carlosgj/Lorentz-Stirrer/Report.pdf

# Magnetohydrodynamic Cocktail Stirrer

Carlos Gross Jones

December 16, 2016

Abstract

1


Figure 1: First iteration of contactless stirrer

## 1 Background

The first attempt at a contactless cocktail stirrer was based on a simple application of the Lorentz force. Two copper electrodes placed in a glass tumbler passed a current through the liquid, while a strong magnet (a 2”x1”x³⁄4” N45 block from United Nuclear Scientific LLC) under the tumbler provided an orthogonal magnetic field (Fig. 1). Assuming time-invariance, the force applied on a differential element dV in a current field J~ and an orthogonal magnetic field B~ can be found from the element length d` parallel to the current and cross-sectional area dA normal to the current:
F~ = qV~ × B~ | (1)

F~ = I

~` × B | (2)
I = |J|dA | (3)
(4)

(Valid because dA is defined to be normal to J~.)

dF~ = |J~|dAd` × B~ | (5)

Since, in this case, the magnetic and current fields are orthogonal, and since the current field is approximately uniform between the electrodes (simply the total current divided by the electrode area),

dF~ = |J~||B~ |dA d` | (6)

F~ =

# Z Z Z

V

|J~||B~ |dA d` | (7)

Given an electrode area of A and spacing of L and approximating both the current and magnetic field to be uniform between the electrodes,

F~ = |B~ |L

# Z Z Z

A

|J~|dA = |B~ |IL | (8)

2

This design did work in principle; the Lorentz force produced a pumping action, where fluid would flow down the centerline between the electrodes and recirculate along the walls of the tumbler. However, since a large current was flowing through a fluid, significant electrolysis occurred, which, in addition to producing potentially dangerous hydrogen and oxygen gas, affected the taste of the cocktail due to the electrolysis products.

## 2 Theoretical Background

Since the basic application of Lorentz force to pumping was effectively validated (and is in fact well studied [1]), the major problem remaining was the electrolysis of the cocktail. As per Faraday’s Law of Electrolysis:

m˙ =

I
F

M
z

(9)

Where:

m˙ is the mass of electrolysis products appearing at an electrode per unit time;

I is the total current flowing into or out of the electrode;

F is the Faraday constant, 96485 mol/C;

M is molar mass of the original substance;

z is the number of valence electrons of the substance.

Since F is a constant and M and z are properties of the substance, in order to minimize ˙m, I must be minimized. However, pumping force is also directly proportional to I. The central proposal of this project is that currents which circulate entirely within a fluid will not result in electrolysis, because the net current flow through the fluid is zero.
The obvious question is how to produce currents without an external EMF source such as a battery. The proposed solution is to use an external, time-variant magnetic field to induce circulating currents (eddy currents) in a conductive fluid.
For the purposes of a first-pass analysis, the following model will be considered:

The fluid will be a 3” diameter, 3” tall cylinder (based on an approximate cocktail tumbler);

The fluid will be considered to have electrical resistivity ρ and magnetic properties equal to a vacuum (water is in fact weakly diamagnetic, but this is expected to be a negligible contribution);

Since, at this point, the goal is to find the form of the current field and its dependence on Bs,max and ρ, it is not necessary to accurately know the resistivity of an actual cocktail; those values are calculated separately.
In fact, this application is an adaption of the well-studied eddy current brake (Fig. 2). In this case, however, the magnets are made to spin, resulting in “dragging” of the cylinder. Specifically, if a magnetic field passing through a conductive cylinder radially is made to rotate about the cylinder’s axis, currents will be produced in the cylinder, which interact with the field via Lorentz force. Since the strength of the eddy currents, and by extension the resulting force, is proportional to dB
dt

, both the strength of the applied magnetic field and its rate of change should be maximized.

### 2.1 General Design

The obvious way to produce a strong time-variant magnetic field is with an AC solenoid: they are well characterized and fairly easy to control, and of course relatively easy to build. Unfortunately, to produce the high field strengths needed (on the order of 1 T), the power required for a normal solenoid exceeds the

3


Figure 2: Eddy current disk brake

capabilities of household circuits. Due to the expense and safety issues, a superconducting solenoid was not practical. Therefore, large permanent magnets were considered. 3” dia. x 1” thick NdFeB45 magnets from United Nuclear Scientific LLC were chosen based on field strength per dollar ($140 and maximum B~ · ~n of ≈0.42 T). In order to produce the greatest possible magnetic field, four of these magnets are arranged in a quadrupole configuration. In addition, high-permeability material (in this case, 1020 steel) is used to provide return paths for the field, further increasing the intensity inside the assembly (Fig. 3).
The downside of permanent magnets, of course, is that they must be in motion to produce a time-variant field. In this case, the quadrupole assembly must be spun about the axis of the cocktail, producing circular forces on the liquid (Fig. 4).

## 3 Rotor Design

## 4 Property Measurements

### 4.1 Cocktail Resistivity

### 4.2 Rotor Field Measurement

## References

[1] Takezawa, | Setsuo | et | al. | “Operation | of | the | Thruster | for | Superconducting | Elec-
tromagnetohydrodynamic | Propulsion | Ship | YAMATO | 1.” | Bulletin | of | the | M.E.S.J
23.1 | (1993): | 46-55. | Japan | Institute | of | Marine | Engineering. | Web. | 21 | Aug. | 2016.
<http://www.jime.jp/e/publication/bulletin/english/pdf/mv23n011995p46.pdf¿.>
[2] Matula, | R. A. “Electrical Resistivity of Copper, | Gold, | Palladium, | and Silver.” | Jour-
nal of Physical and Chemical Reference Data 8.4 (1979): | 1161. Web. 23 Aug. 2016.
<http://www.nist.gov/data/PDFfiles/jpcrd155.pdf>.
[3] Bowler, John R., and Theodoros P. Theodoulidis. “Eddy Currents Induced in a Conducting Rod of Finite Length by a Coaxial Encircling Coil.” Journal of Physics D: Applied Physics 38.16 (2005): 2861-868. Web. 23 Aug. 2016.

4

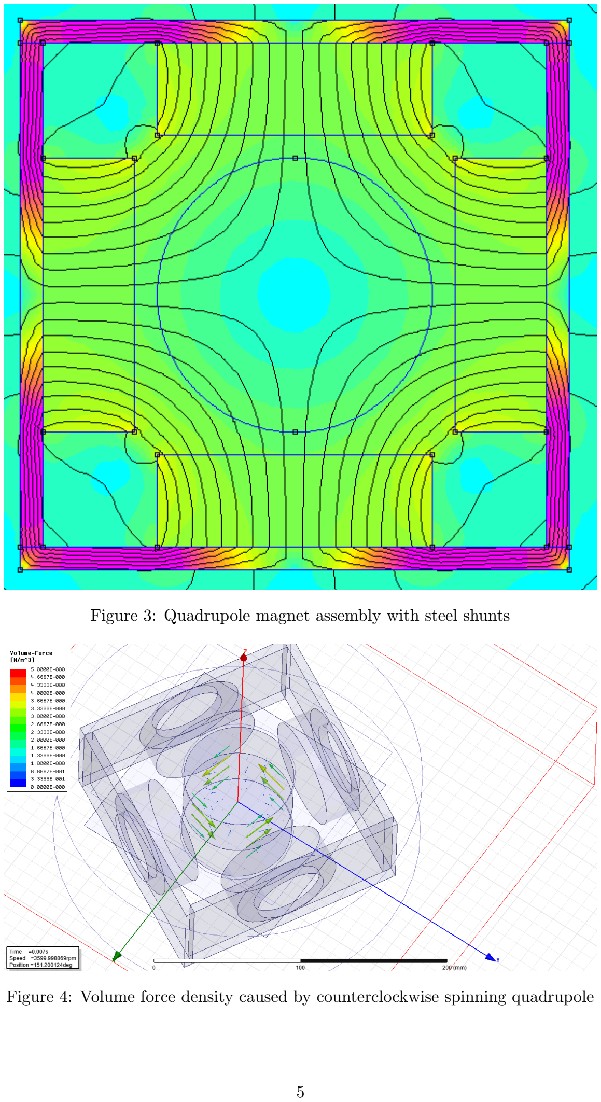
[picture p6: page 5]

Figure 3: Quadrupole magnet assembly with steel shunts

Figure 4: Volume force density caused by counterclockwise spinning quadrupole

5
