carlosgj/Lorentz-Stirrer/CAD/Bare Frame Remder.png

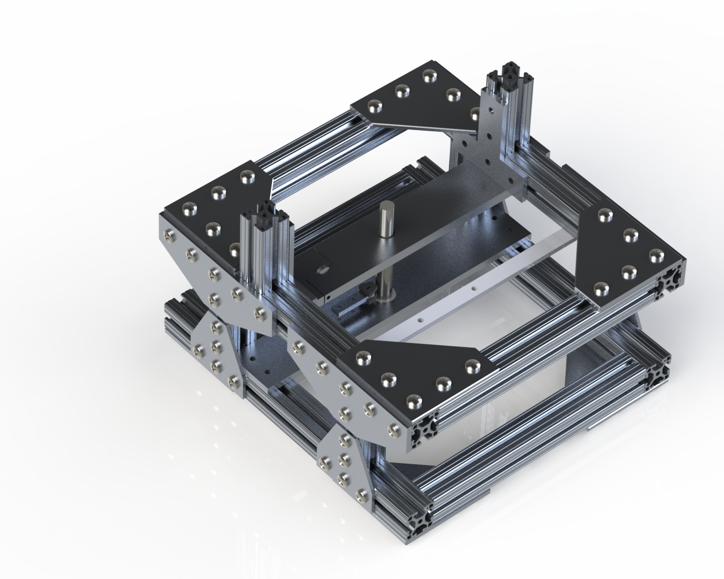
CAD/Bare Frame Remder.png
