carlosgj/Lorentz-Stirrer/CAD/Cutaway.PNG

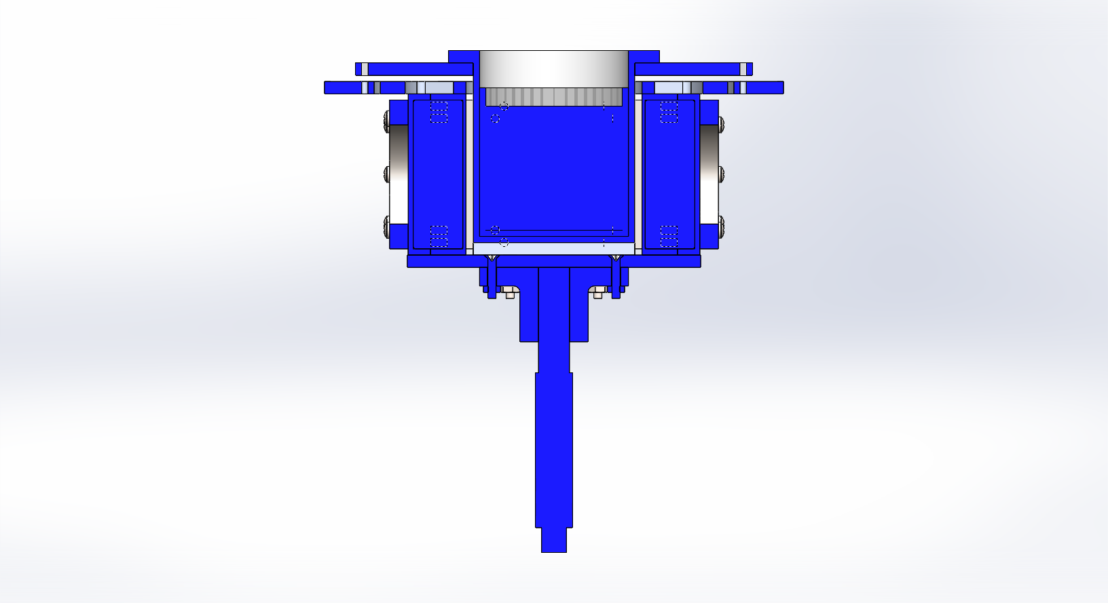
CAD/Cutaway.PNG
