carlosgj/Lorentz-Stirrer/CAD/Pictures/Cutaway.PNG

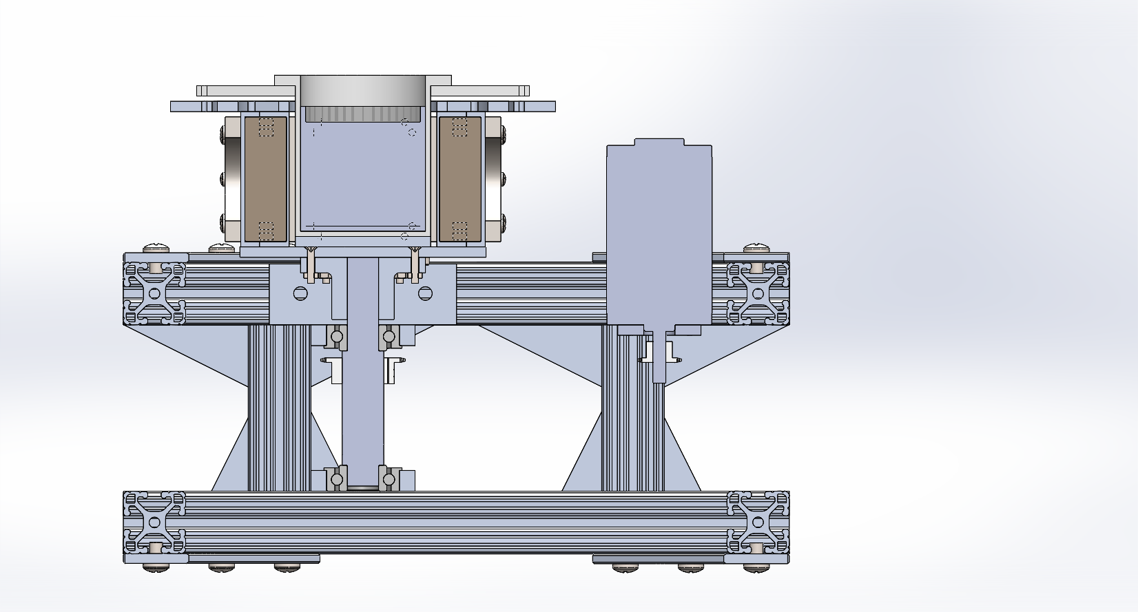
CAD/Pictures/Cutaway.PNG
