carlosgj/Lorentz-Stirrer/CAD/Pictures/Overall Render.png

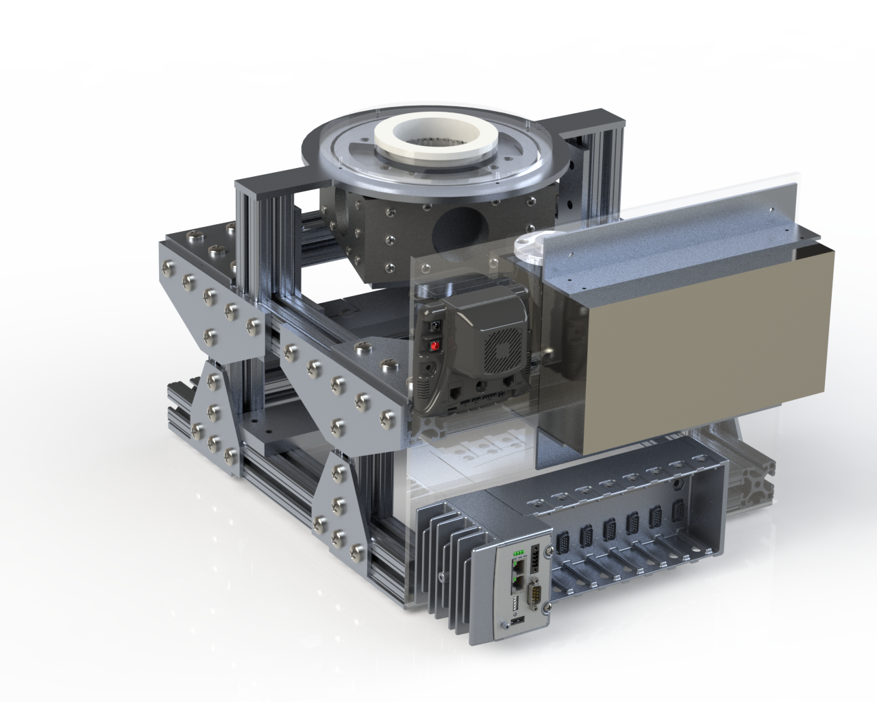
CAD/Pictures/Overall Render.png
