carlosgj/Lorentz-Stirrer/CAD/Spinner and Cup Render.png

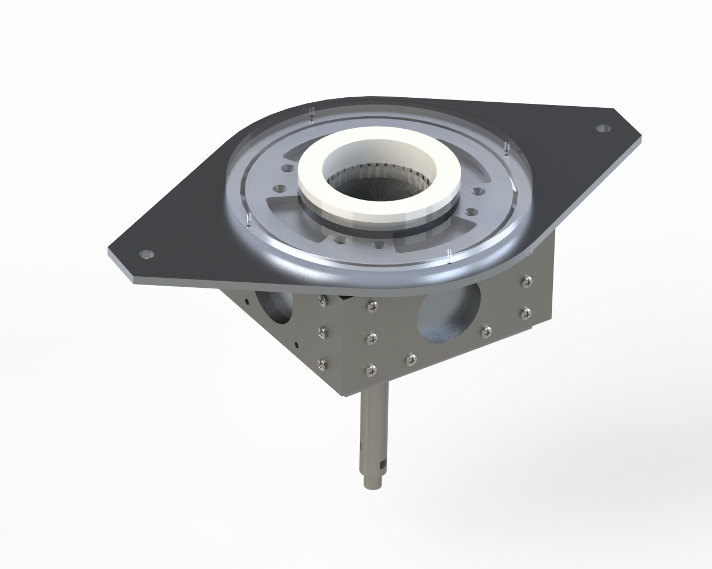
CAD/Spinner and Cup Render.png
