carlosgj/Lorentz-Stirrer/FEMM/Quadrupole.png

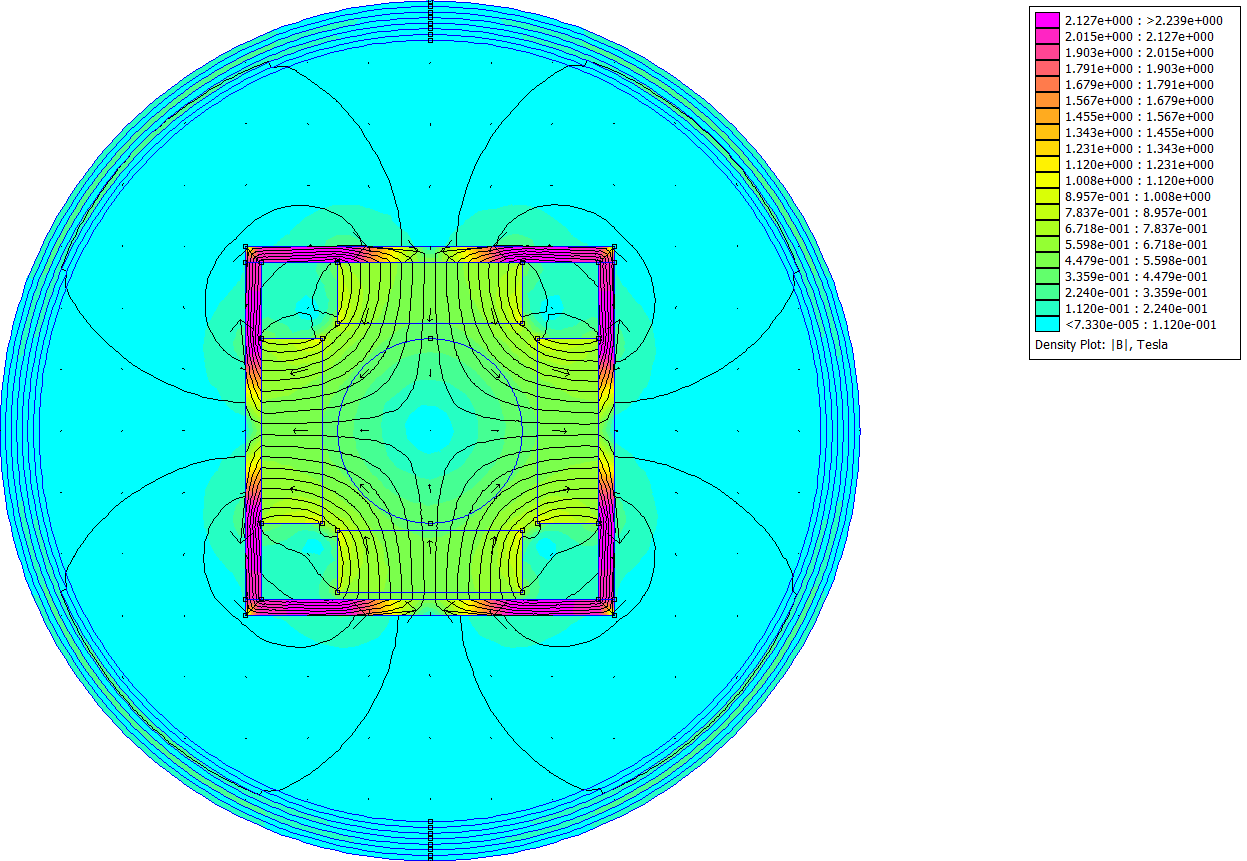
FEMM/Quadrupole.png
