carlosgj/Lorentz-Stirrer/VolumeForceDensity.gif

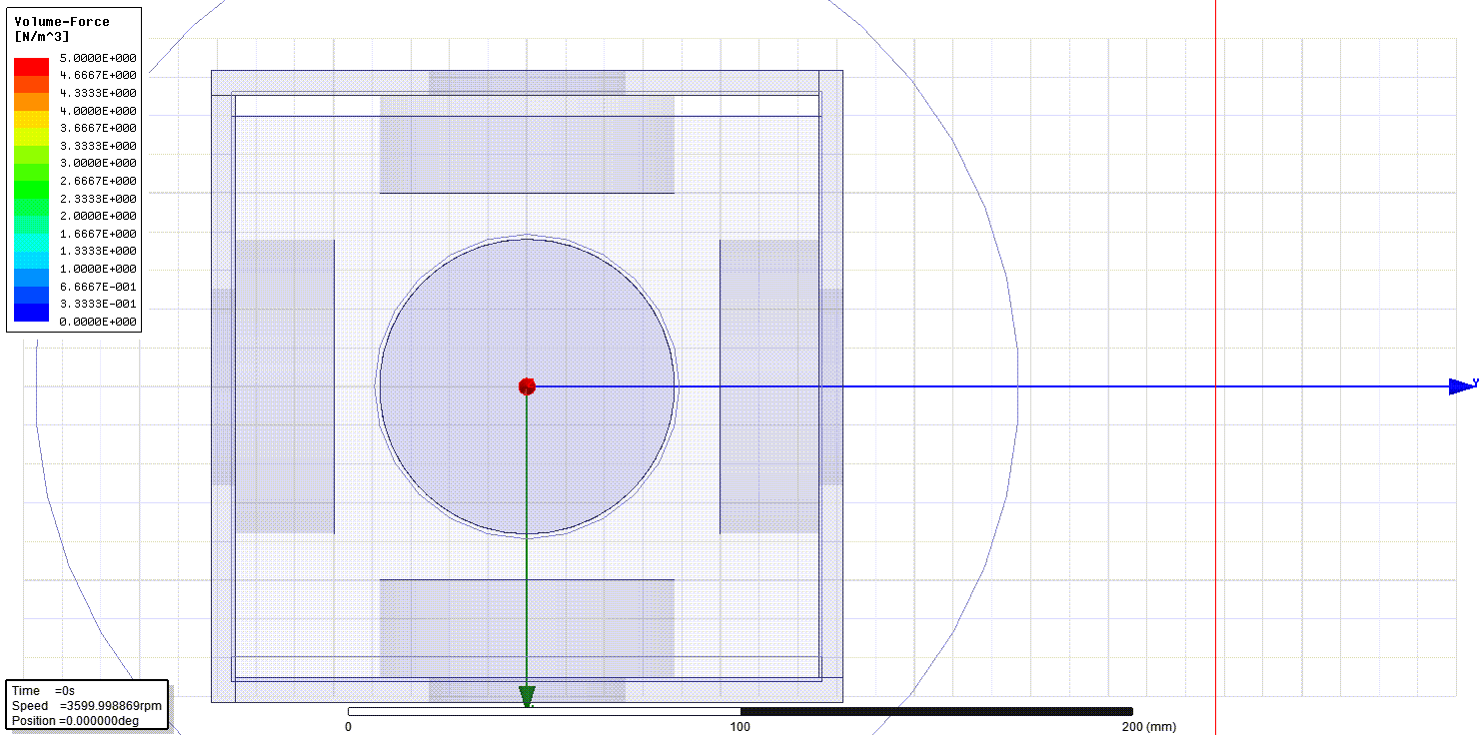
VolumeForceDensity.gif
