carlosgj/Lorentz-Stirrer/CAD/BOM.xlsx

ITEM NO. | PART NUMBER | Vendor | Part No | QTY. | Custom? | Have | Price | Line Total
3 | 8020 5 hole plate | McMaster | 47065T271 | 8 | NO | NO | $9.74 | $77.92 | YES
6 | 8020 T plate | McMaster | 47065T279 | 4 | NO | NO | $10.18 | $40.72 | NO
7 | 8020 T plate 2 | 80/20 | 4310 | 4 | NO | NO | $8.25 | $33.00
9 | 8020 thin t | 80/20 | 4480 | 2 | NO | NO | $8.00 | $16.00
15 | Magnet 31 | United Nuclear | Magnet 31 | 4 | NO | NO | $120.00 | $480.00
30 | CIM motor | AndyMark | 28 | 1 | NO | NO | $28.00 | $28.00
31 | 2737T101 | McMaster | 2737T101 | 1 | NO | NO | $9.44 | $9.44
32 | 2737T176 | McMaster | 2737T176 | 1 | NO | NO | $13.20 | $13.20
34 | Glass |  |  | 1 | NO | YES |  | $0.00
36 | 6383K251 | McMaster | 6383K251 | 2 | NO | NO | $11.14 | $22.28
39 | Load Cell |  |  | 1 | NO | YES |  | $0.00
41 | Jaguar |  |  | 1 | NO | YES | $80.00 | $0.00
42 | cRIO |  |  | 1 | NO | YES | $4892.00 | $0.00
43 | Power Supply | Mouser | 709-SE600-12 | 1 | NO | NO | $91.08 | $91.08
45 | OPB748 Encoder | Mouser | 828-OPB748WZ | 2 | NO | NO | $4.43 | $8.86
1 | 8020 14 inch | McMaster | 47065T808 | 64 | YES | NO | $0.67 | $42.88
2 | 8020 8 inch | McMaster | 47065T808 | 48 | YES | NO | $0.67 | $32.16
5 | 8020 4 inch | McMaster | 47065T808 | 16 | YES | NO | $0.67 | $10.72
8 | 8020 5 inch | McMaster | 47065T808 | 7.239 | YES | NO | $0.67 | $4.85
11 | 8020 Bottom bearing holder |  |  | 1 | YES | NO |  | $0.00
12 | 8020 top bearing holder |  |  | 1 | YES | NO |  | $0.00
13 | bottom spinner plate |  |  | 1 | YES | NO |  | $0.00
14 | magnet holder |  |  | 4 | YES | NO |  | $0.00
16 | magnet plate |  |  | 4 | YES | NO |  | $0.00
19 | top spinner plate |  |  | 1 | YES | NO |  | $0.00
20 | Spinner Hub |  |  | 1 | YES | NO |  | $0.00
22 | End Shunt |  |  | 2 | YES | NO |  | $0.00
23 | Side Shunt |  |  | 2 | YES | NO |  | $0.00
24 | Shunt Gusset |  |  | 4 | YES | NO |  | $0.00
28 | 8020 shaft |  |  | 1 | YES | NO |  | $0.00
29 | 8020 motor holder |  |  | 1 | YES | NO |  | $0.00
33 | Emergency bushing |  |  | 1 | YES | NO |  | $0.00
35 | Glass Holder |  |  | 1 | YES | NO |  | $0.00
37 | Acrylic Top |  |  | 1 | YES | NO |  | $0.00
38 | 8020 top bearing holder end |  |  | 1 | YES | NO |  | $0.00
40 | Front Mounting Plate |  |  | 1 | YES | NO |  | $0.00
44 | PS Bracket |  |  | 2 | YES | NO |  | $0.00
46 | Encoder Holder |  |  | 1 | YES | NO |  | $0.00
 |  |  |  |  |  |  | TOTAL | $911.11
