carlosgj/Lorentz-Stirrer/CAD/8020 stand.SLDASM

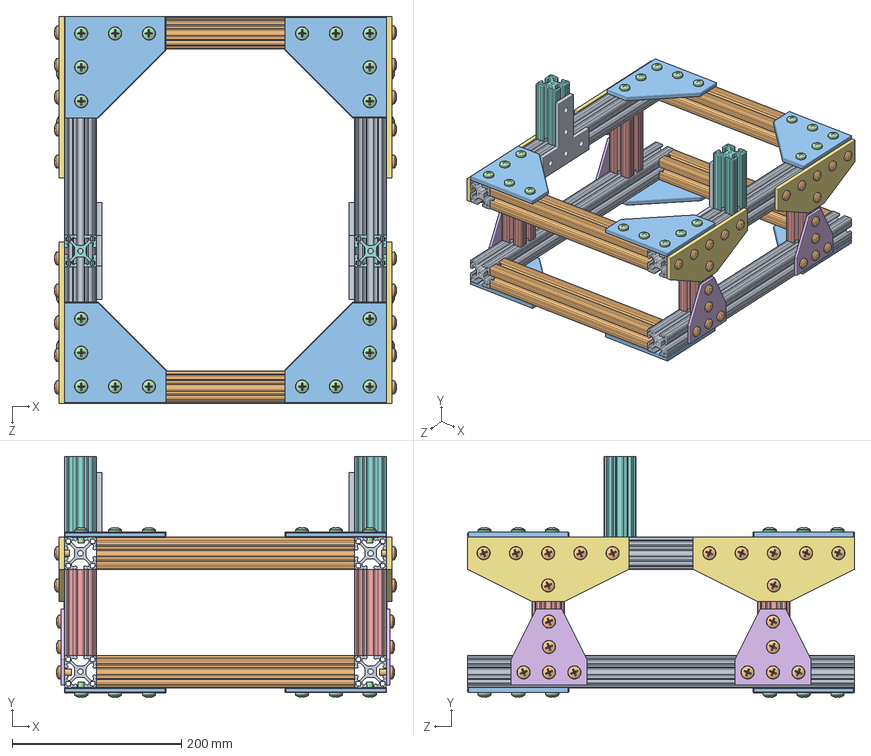
[picture p29: CAD file, 2017-03-15]
CAD/8020 stand.SLDASM
404.7 x 284.8 x 457.3 mm
8020 14 inch x 4
8020 8 inch x 4
8020 5 hole plate x 8
CR-PHMS 0.3125-18x0.5x0.5-N x 40
8020 4 inch x 4
8020 T plate x 4
8020 T plate 2 x 4
8020 5 inch x 2
8020 thin t x 2
CR-PHMS 0.3125-24x0.5x0.5-N x 44
