carlosgj/Lorentz-Stirrer/CAD/CIM Motor/CIM Motor.SLDASM

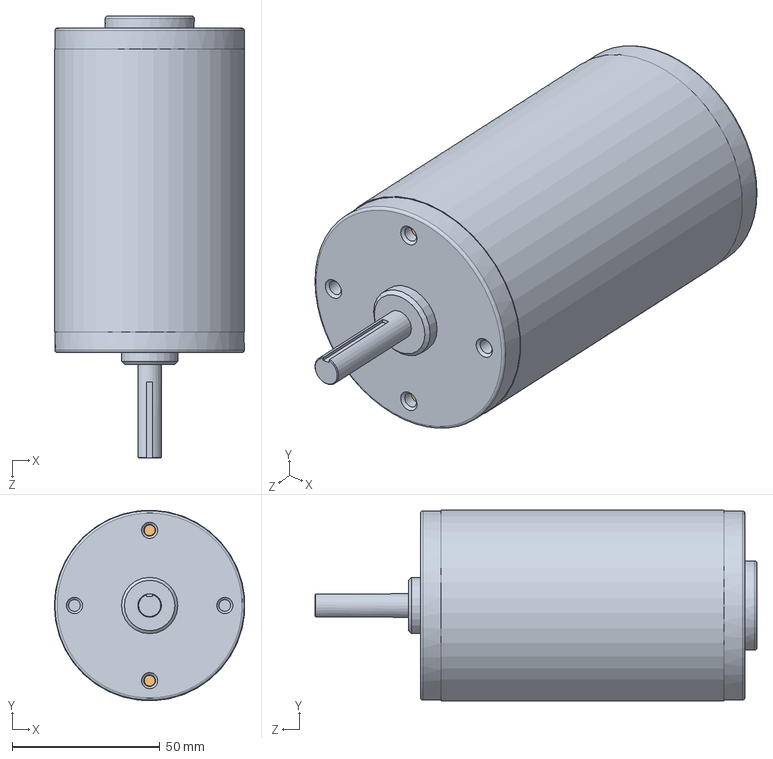
[picture p30: CAD file, 2016-08-16]
CAD/CIM Motor/CIM Motor.SLDASM
64.3 x 64.4 x 149.3 mm
CIM motor
10-24 UNC x 4_ Phillips Pan Head x 2
