carlosgj/Lorentz-Stirrer/CAD/Gearbox/217-2820 Rev1_Public.sldasm

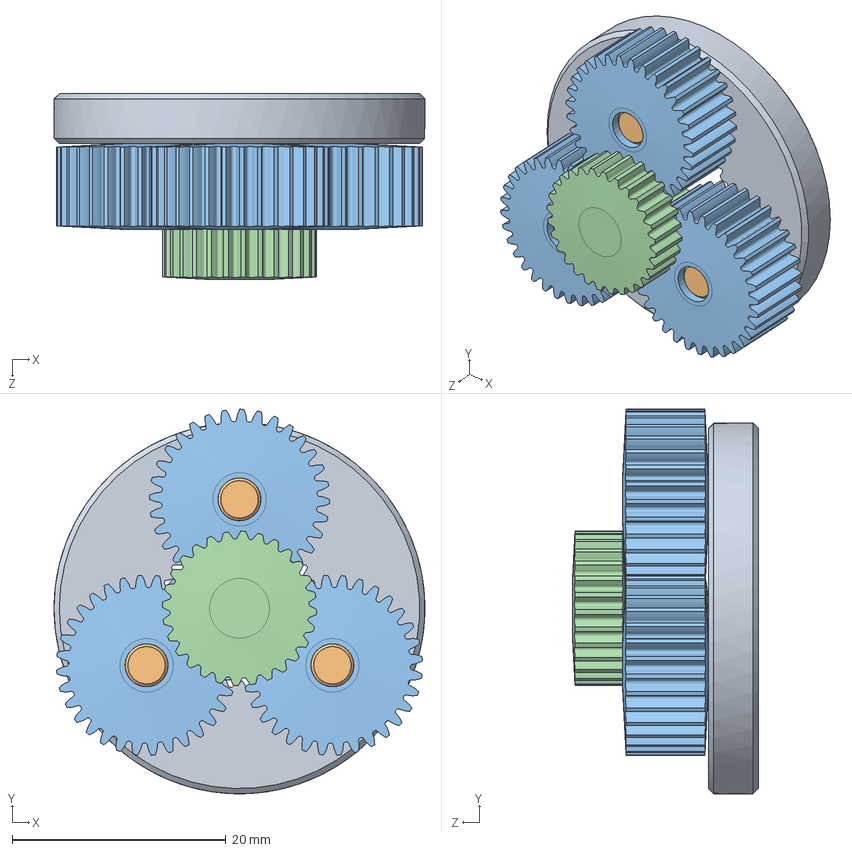
[picture p31: CAD file, 2017-06-16]
CAD/Gearbox/217-2820 Rev1_Public.sldasm
34.7 x 36.0 x 17.4 mm
217-2625-008 Rev1
217-2625-010 Rev1 x 3
217-2625-005 Rev1_Planet_Revolving_Follower01 x 3
217-2625-007 Rev1_Public
