carlosgj/Lorentz-Stirrer/CAD/Spinner assembly.SLDASM

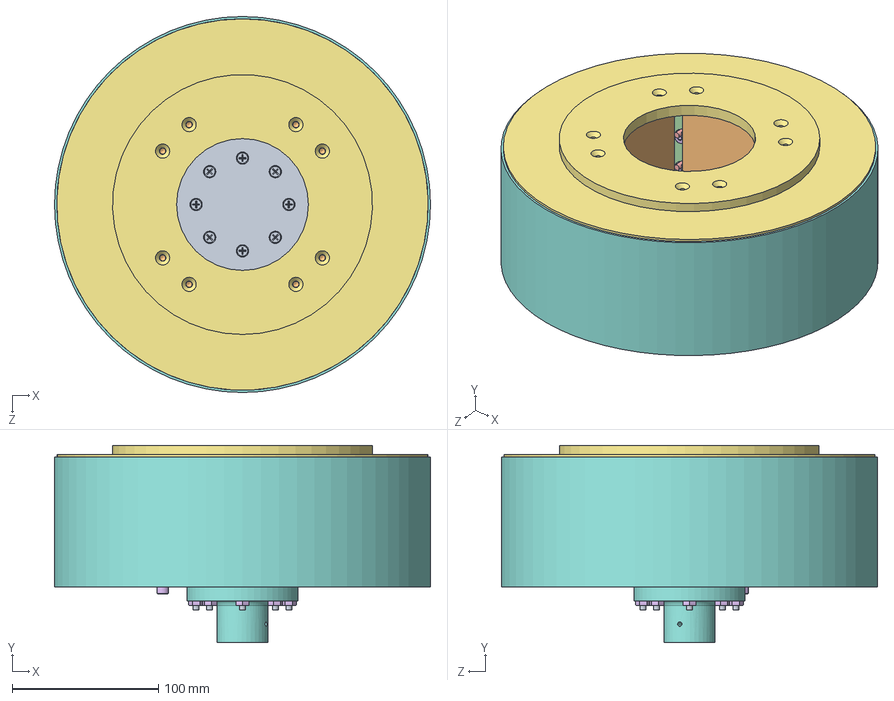
[picture p32: CAD file, 2017-03-15]
CAD/Spinner assembly.SLDASM
257.2 x 134.9 x 257.2 mm
bottom spinner plate
magnet holder x 4
Magnet 31 x 4
magnet plate x 4
CR-FHMS 0.164-32x1x1-N x 16
HX-SHCS 0.19-24x1x1-N
top spinner plate
Spinner Hub
CR-FHM1 0.164-32x0.875x0.875-N x 8
End Shunt x 2
Side Shunt x 2
Shunt Gusset x 4
CR-PHMS 0.164-32x0.75x0.75-N x 24
MSHXNUT 0.164-32-S-N x 32
CR-PHMS 0.164-32x1.25x1-N x 24
