carlosgj/Lorentz-Stirrer/CAD/Gearbox/217-3141.SLDASM

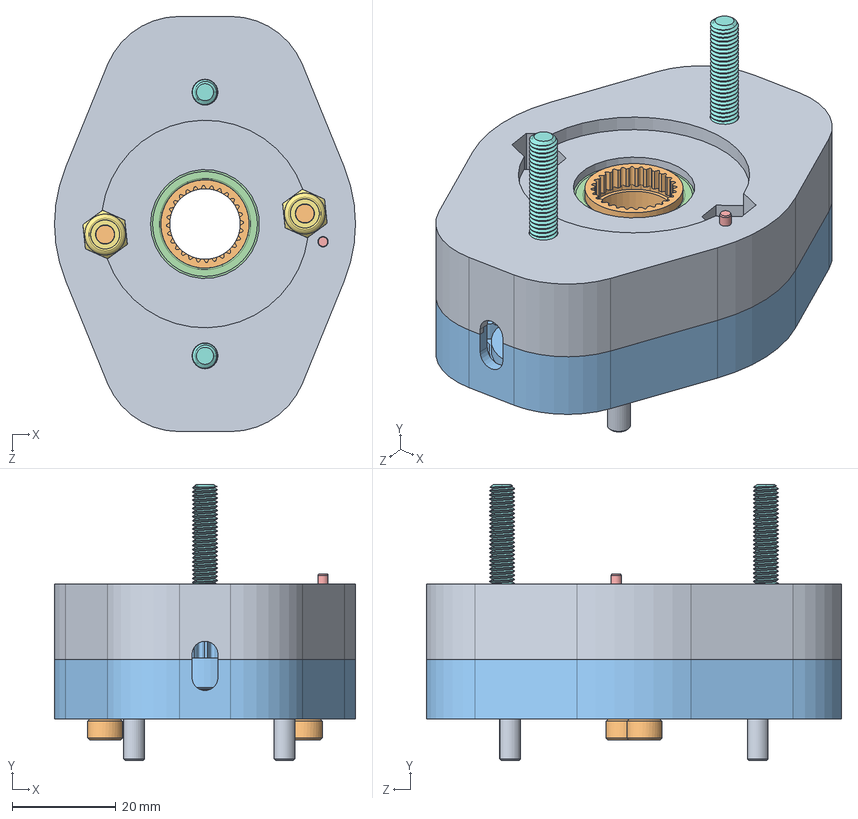
[picture p33: CAD file, 2017-06-16]
CAD/Gearbox/217-3141.SLDASM
58.0 x 53.2 x 80.0 mm
217-3141-001 Rev1
217-3141-007 Rev1_30T 32DP
217-3141-006 Rev1_30T 32DP x 2
PINL-M020-006-S
SSS1032-0188-ZB x 2
NUT-832-NYLOCK x 2
91251A346_91251A346 x 2
SSA_SSAM4-0010ZC x 4
SSA_SSA0832-0750ZC x 2
217-3141-004 Rev1
217-2625-013 Rev1 x 2
