carlosgj/Lorentz-Stirrer/CAD/Gearbox/Gearbox.SLDASM

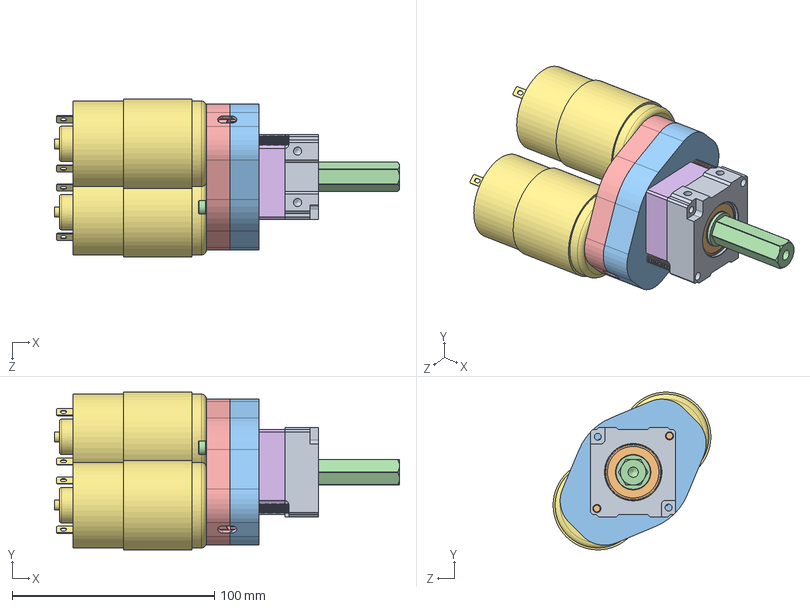
[picture p34: CAD file, 2017-06-16]
CAD/Gearbox/Gearbox.SLDASM
170.7 x 78.0 x 78.0 mm
217-2625-026 Rev1
217-2742-001 Rev4 x 2
217-2625-017 Rev1_9714K61
217-2625-003 Rev1
217-2625-018 Rev1_98541A410
217-2816-001 Rev1
217-2625-008 Rev1
217-2625-010 Rev1 x 3
217-2625-005 Rev1_Planet_Revolving_Follower01 x 3
217-2625-007 Rev1_Public
217-3141-001 Rev1
217-3141-007 Rev1_30T 32DP
217-3141-006 Rev1_30T 32DP x 2
PINL-M020-006-S
SSS1032-0188-ZB x 2
NUT-832-NYLOCK x 2
91251A346_91251A346 x 2
SSA_SSAM4-0010ZC x 4
SSA_SSA0832-0750ZC x 2
217-3141-004 Rev1
217-2625-013 Rev1 x 2
775 Pro x 2
