carlosgj/Lorentz-Stirrer/CAD/Gearbox/217-2817-STEP.SLDASM

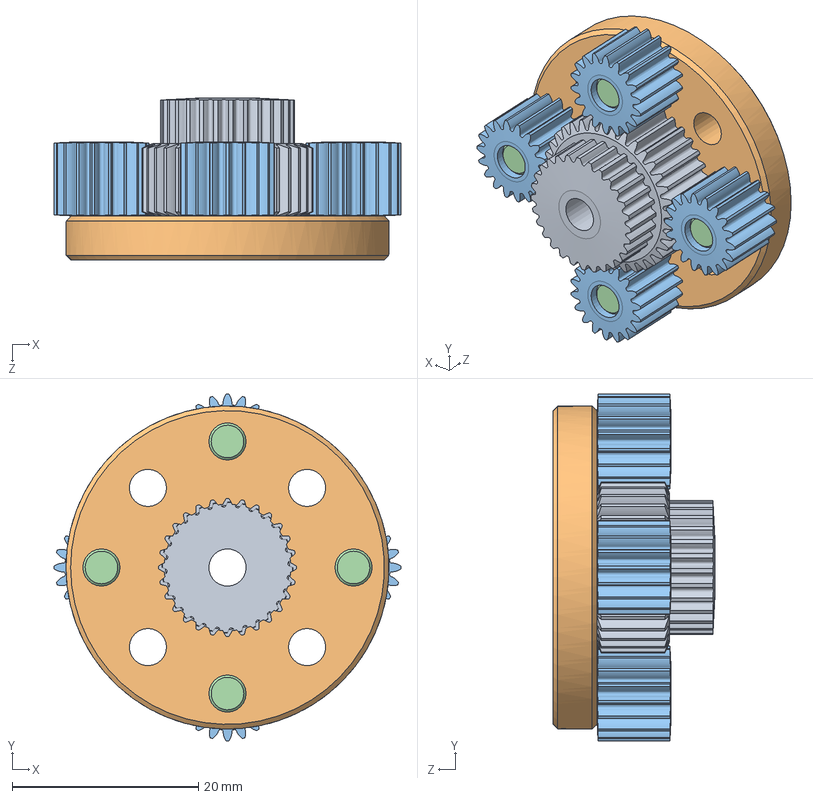
[picture p35: CAD file, 2017-06-16]
CAD/Gearbox/217-2817-STEP.SLDASM
37.3 x 37.3 x 17.4 mm
217-2724-001 Rev1_Sun_Driver01
217-2724-002 Rev1
217-2724-003 Rev1_Planet_Revolving_Follower01 x 4
217-2625-010 Rev1 x 4
