carlosgj/Lorentz-Stirrer/CAD/8020 base.SLDASM

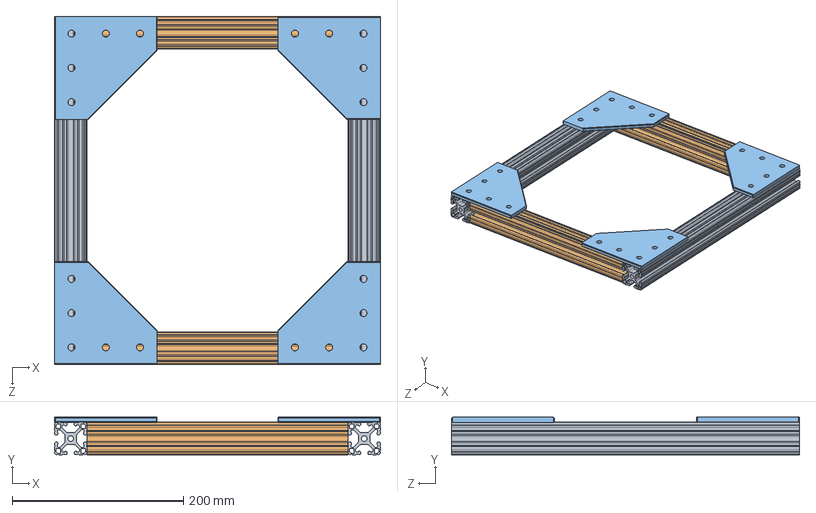
[picture p36: CAD file, 2017-02-09]
CAD/8020 base.SLDASM
381.0 x 44.3 x 406.5 mm
8020 14 inch x 2
8020 8 inch x 2
8020 5 hole plate x 4
