carlosgj/Lorentz-Stirrer/CAD/Gearbox/v2-VersaPlanetary-1stage-with-775pro-20161031.SLDASM

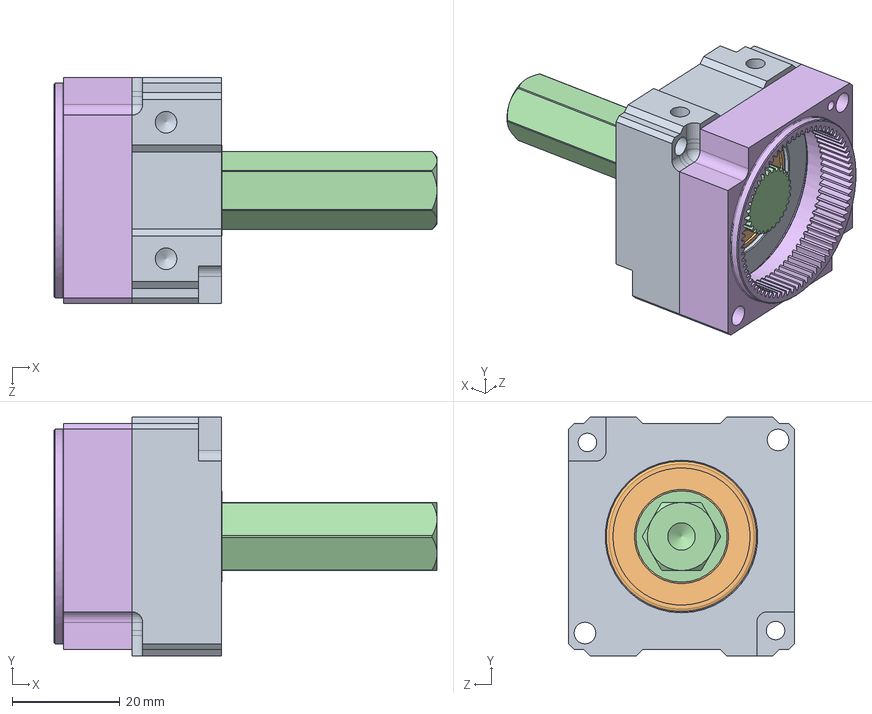
[picture p37: CAD file, 2017-06-16]
CAD/Gearbox/v2-VersaPlanetary-1stage-with-775pro-20161031.SLDASM
71.3 x 44.5 x 42.0 mm
217-2625-026 Rev1
217-2742-001 Rev4 x 2
217-2625-017 Rev1_9714K61
217-2625-003 Rev1
217-2625-018 Rev1_98541A410
217-2816-001 Rev1
