carlosgj/Lorentz-Stirrer/CAD/Magnet Assembly.SLDASM

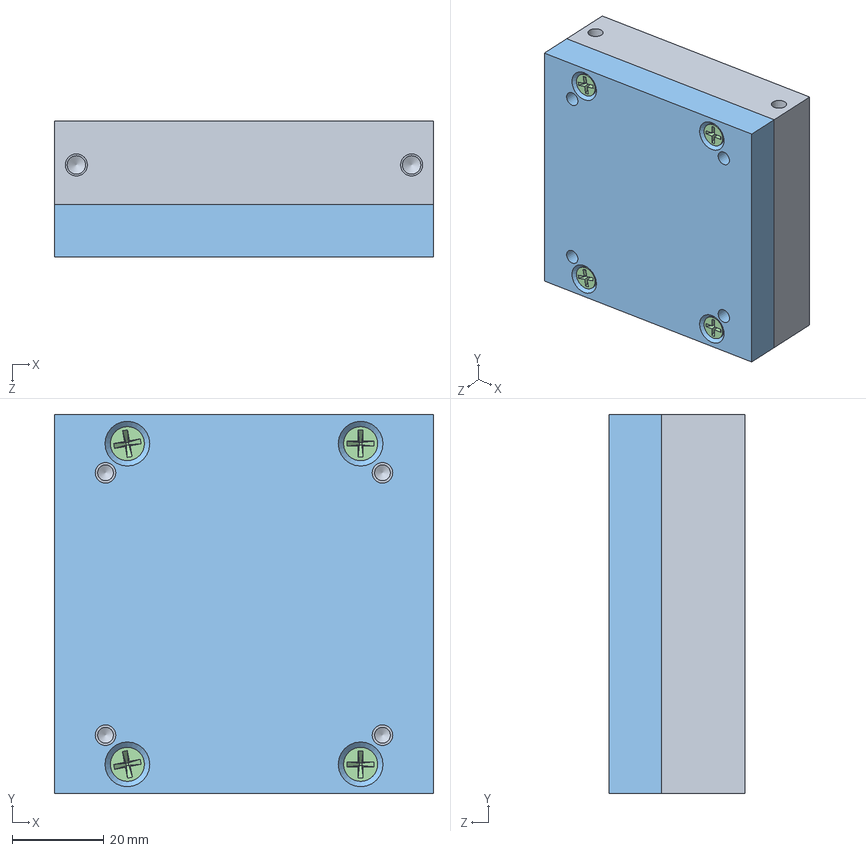
[picture p38: CAD file, 2016-10-20]
CAD/Magnet Assembly.SLDASM
82.5 x 82.5 x 29.5 mm
magnet holder
Magnet 31
magnet plate
CR-FHMS 0.164-32x1x1-N x 4
