carlosgj/Lorentz-Stirrer/CAD/8020.SLDASM

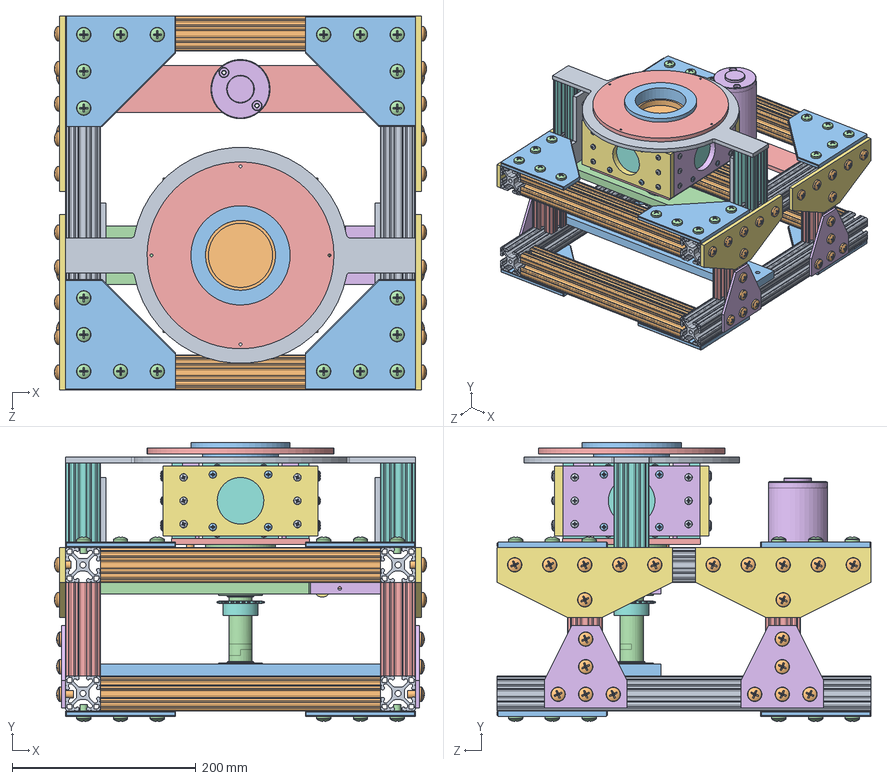
[picture p39: CAD file, 2016-10-20]
CAD/8020.SLDASM
404.7 x 303.7 x 406.5 mm
8020 14 inch x 4
8020 8 inch x 4
8020 5 hole plate x 8
CR-PHMS 0.3125-18x0.5x0.5-N x 40
8020 4 inch x 4
8020 T plate x 4
8020 T plate 2 x 4
8020 5 inch x 2
8020 thin t x 2
CR-PHMS 0.3125-24x0.5x0.5-N x 44
8020 Bottom bearing holder
8020 top bearing holder
bottom spinner plate
magnet holder x 4
Magnet 31 x 4
magnet plate x 4
CR-FHMS 0.164-32x1x1-N x 16
HX-SHCS 0.19-24x1x1-N
top spinner plate
Spinner Hub
CR-FHM1 0.164-32x0.875x0.875-N x 8
End Shunt x 2
Side Shunt x 2
Shunt Gusset x 4
CR-PHMS 0.164-32x0.75x0.75-N x 24
MSHXNUT 0.164-32-S-N x 32
CR-PHMS 0.164-32x1.25x1-N x 24
8020 shaft
8020 motor holder
CIM motor
12t sprocket
24t sprocket
Emergency bushing
Glass
Glass Holder
6383K251_BALL BEARING x 2
Glass Support
8020 top bearing holder end
Load Cell
