carlosgj/Lorentz-Stirrer/CAD/Solenoid.SLDASM

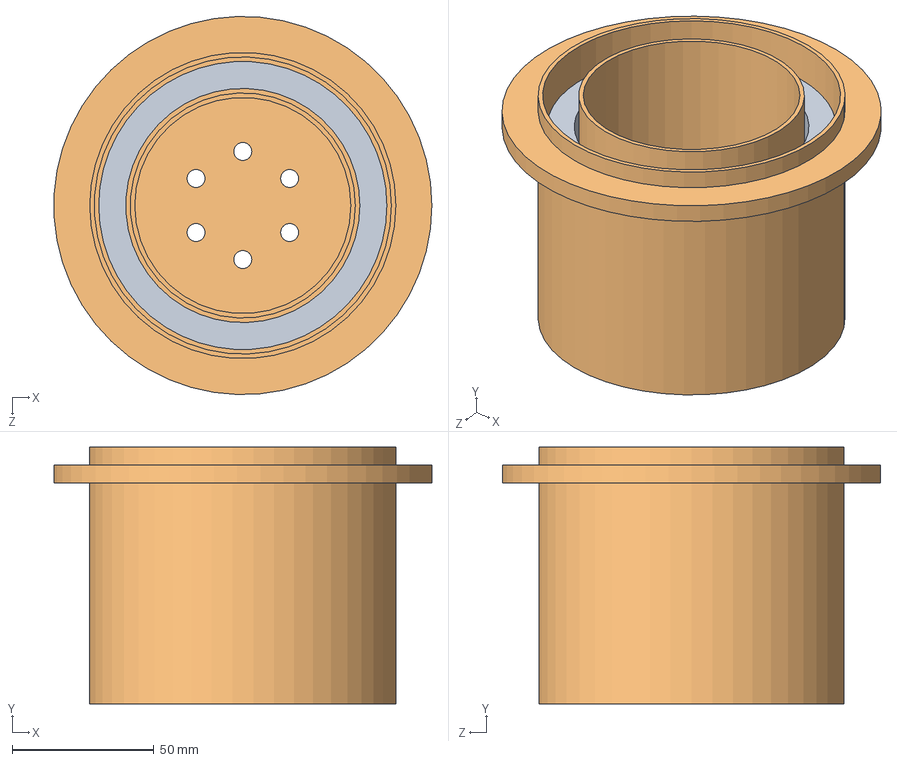
[picture p40: CAD file, 2016-10-16]
CAD/Solenoid.SLDASM
133.2 x 90.5 x 133.3 mm
coil
LN2 Cup
