carlosgj/Lorentz-Stirrer/CAD/Base.SLDASM

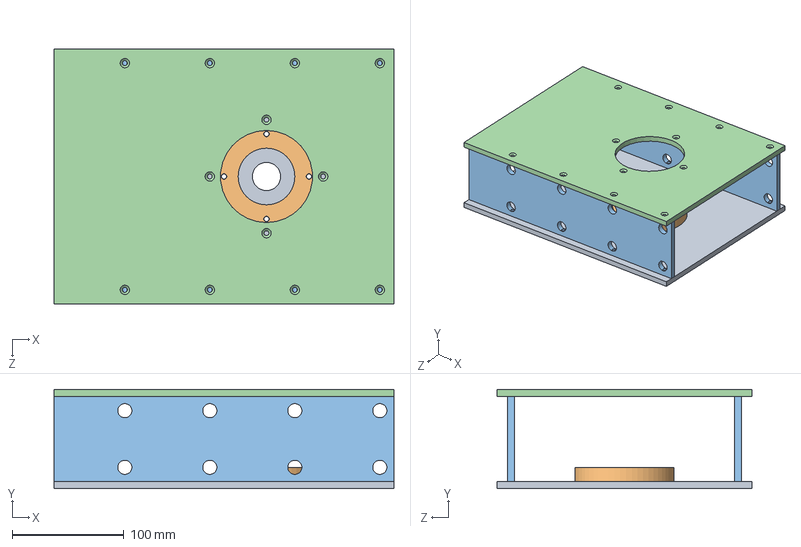
[picture p41: CAD file, 2016-08-16]
CAD/Base.SLDASM
304.8 x 88.9 x 228.6 mm
Bottom Plate
Bottom Bearing Holder
Long spacer x 2
Top Plate
