carlosgj/Lorentz-Stirrer/CAD/Motor Mounting Plate.SLDPRT

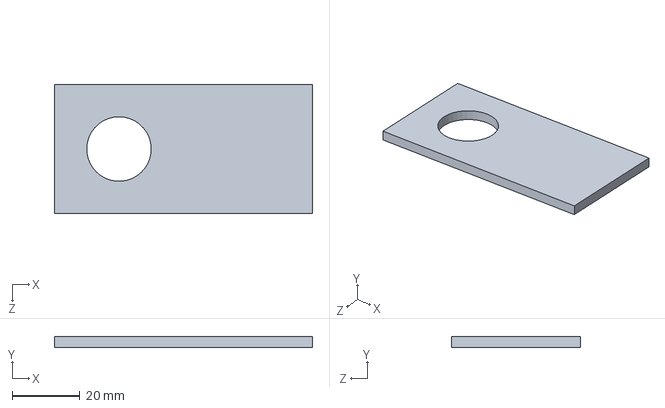
[picture p42: CAD file, 2017-06-16]
CAD/Motor Mounting Plate.SLDPRT
76.2 x 3.17 x 38.1 mm
