carlosgj/Lorentz-Stirrer/CAD/Glass Holder.SLDPRT

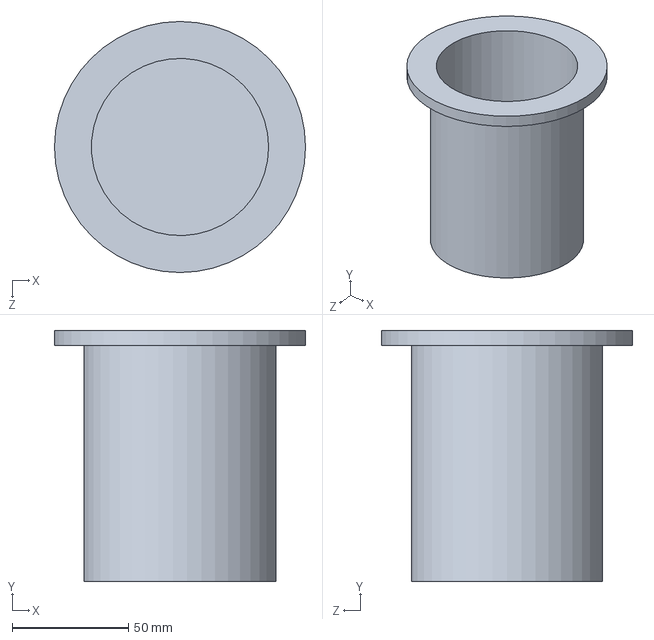
[picture p43: CAD file, 2017-03-15]
CAD/Glass Holder.SLDPRT
108.0 x 108.0 x 108.0 mm
