carlosgj/Lorentz-Stirrer/CAD/Front Mounting Plate.SLDPRT

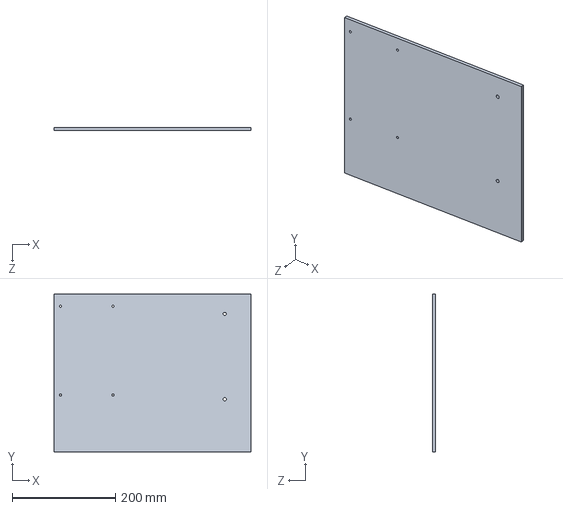
[picture p44: CAD file, 2017-03-15]
CAD/Front Mounting Plate.SLDPRT
381.0 x 304.8 x 6.35 mm
