carlosgj/Lorentz-Stirrer/CAD/Aero Cowling.SLDPRT

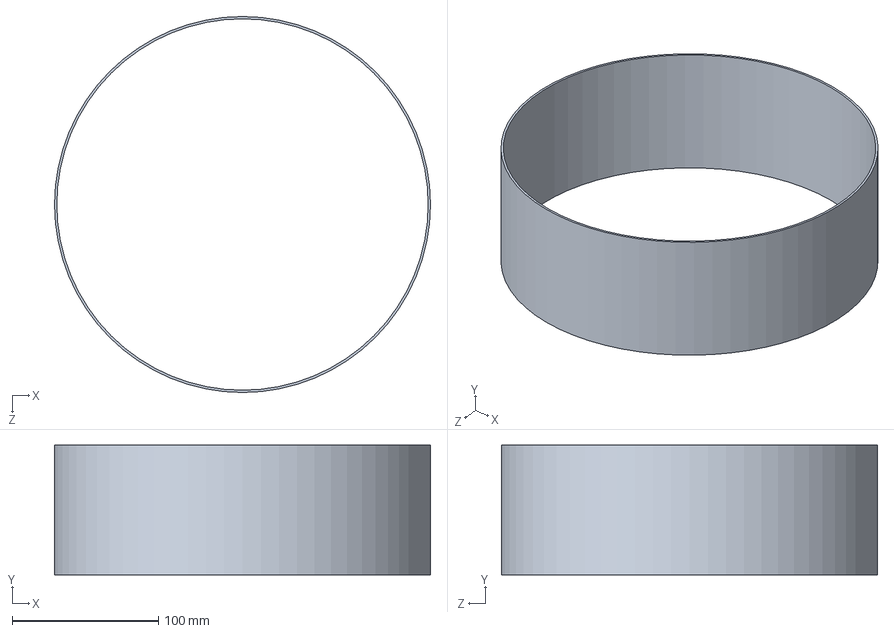
[picture p45: CAD file, 2017-03-15]
CAD/Aero Cowling.SLDPRT
257.2 x 88.9 x 257.2 mm
