carlosgj/Lorentz-Stirrer/CAD/8020 5 inch.SLDPRT

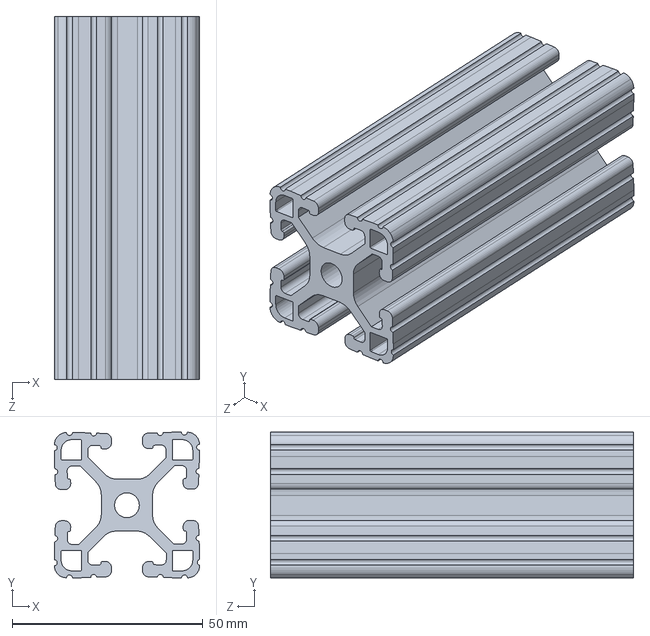
[picture p46: CAD file, 2017-03-15]
CAD/8020 5 inch.SLDPRT
38.1 x 38.2 x 95.2 mm
