carlosgj/Lorentz-Stirrer/CAD/top spinner plate.SLDPRT

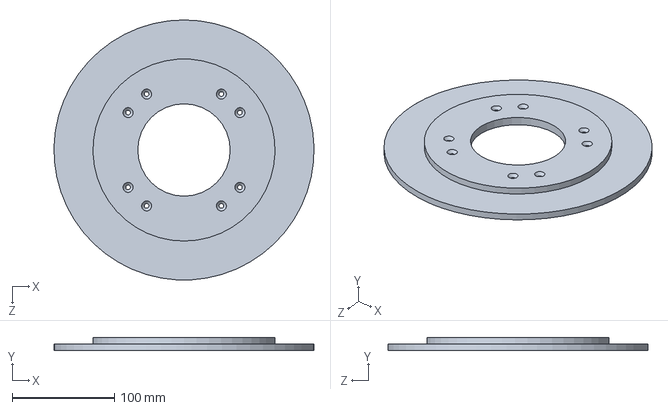
[picture p47: CAD file, 2017-03-15]
CAD/top spinner plate.SLDPRT
253.9 x 12.7 x 254.0 mm
