carlosgj/Lorentz-Stirrer/CAD/bottom spinner plate.SLDPRT

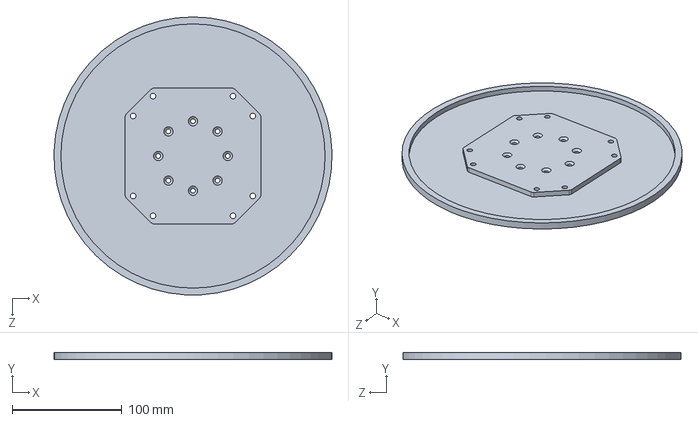
[picture p48: CAD file, 2017-03-15]
CAD/bottom spinner plate.SLDPRT
253.9 x 6.35 x 254.0 mm
