carlosgj/Lorentz-Stirrer/CAD/8020 14 inch.SLDPRT

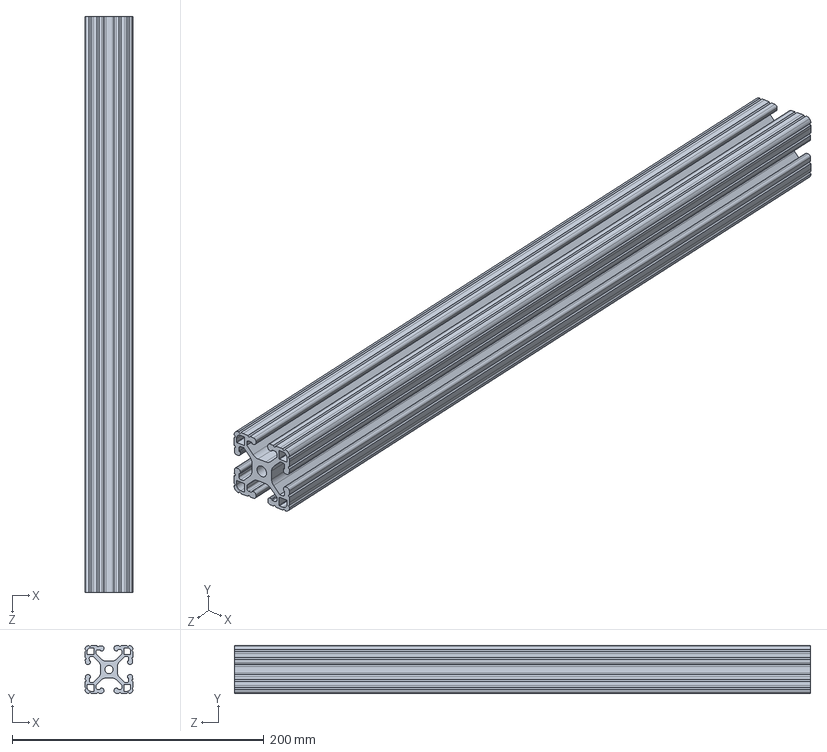
[picture p49: CAD file, 2017-02-09]
CAD/8020 14 inch.SLDPRT
38.1 x 38.2 x 457.2 mm
