carlosgj/Lorentz-Stirrer/CAD/Motor Mounting Rail.SLDPRT

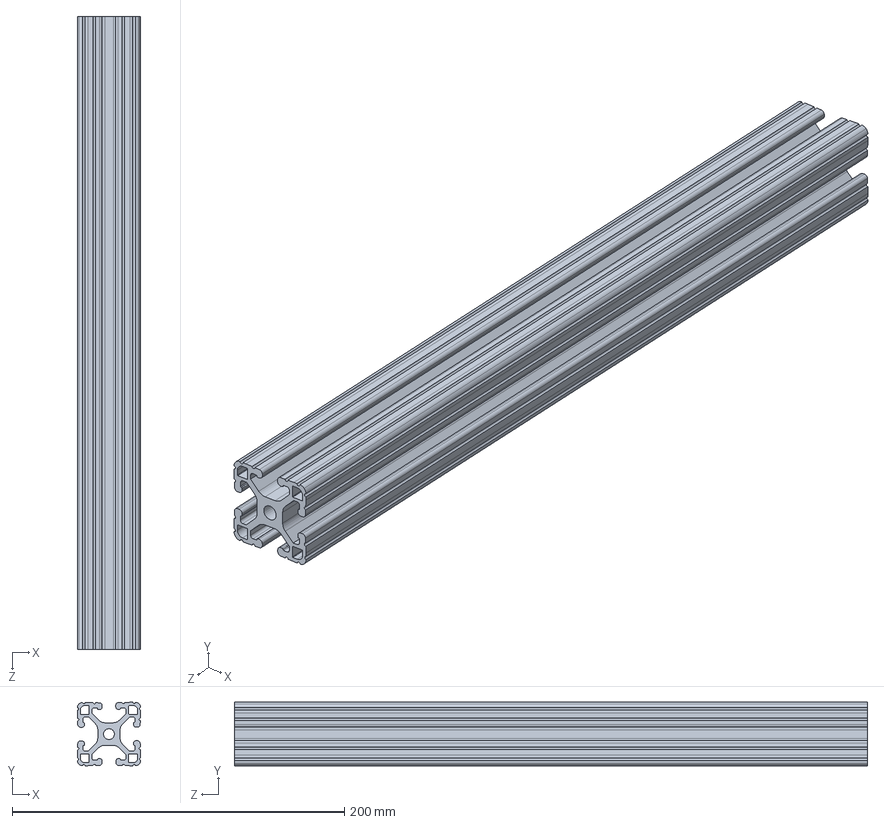
[picture p50: CAD file, 2017-02-09]
CAD/Motor Mounting Rail.SLDPRT
38.1 x 38.2 x 381.0 mm
