carlosgj/Lorentz-Stirrer/CAD/SE-1000-12.SLDPRT

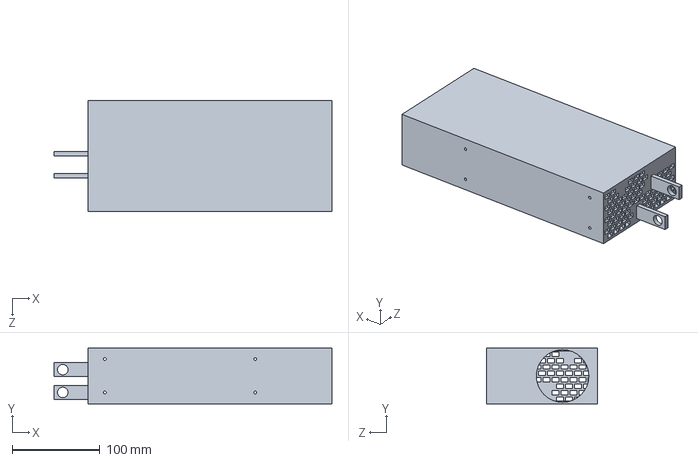
[picture p51: CAD file, 2017-02-09]
CAD/SE-1000-12.SLDPRT
317.0 x 63.5 x 127.0 mm
