carlosgj/Lorentz-Stirrer/CAD/8020 top bearing holder.SLDPRT

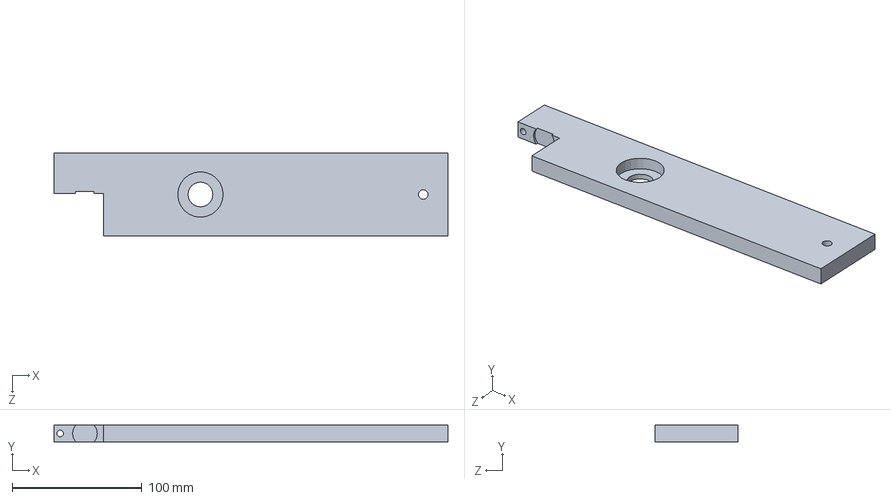
[picture p52: CAD file, 2016-12-03]
CAD/8020 top bearing holder.SLDPRT
303.2 x 12.7 x 63.5 mm
