carlosgj/Lorentz-Stirrer/CAD/Gearbox/217-2625-017 Rev1_9714K61.sldprt

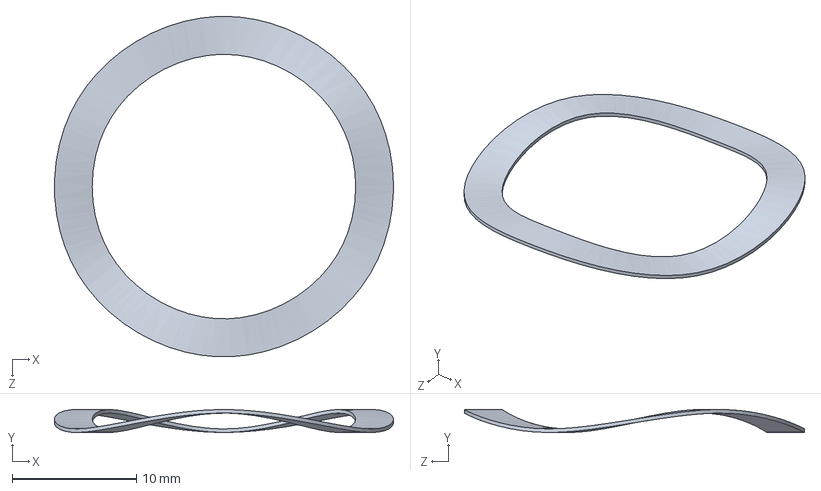
[picture p53: CAD file, 2017-06-16]
CAD/Gearbox/217-2625-017 Rev1_9714K61.sldprt
27.3 x 1.85 x 27.4 mm
