carlosgj/Lorentz-Stirrer/CAD/flex bar.SLDPRT

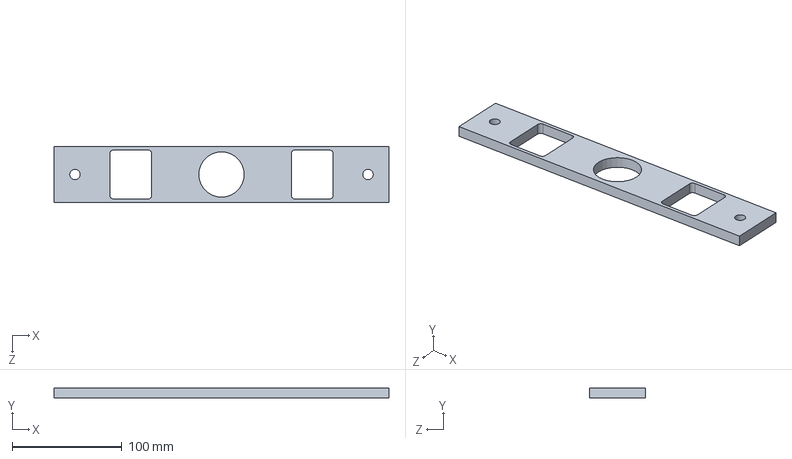
[picture p54: CAD file, 2016-12-03]
CAD/flex bar.SLDPRT
304.8 x 9.53 x 50.8 mm
