carlosgj/Lorentz-Stirrer/CAD/Spinner Hub.SLDPRT

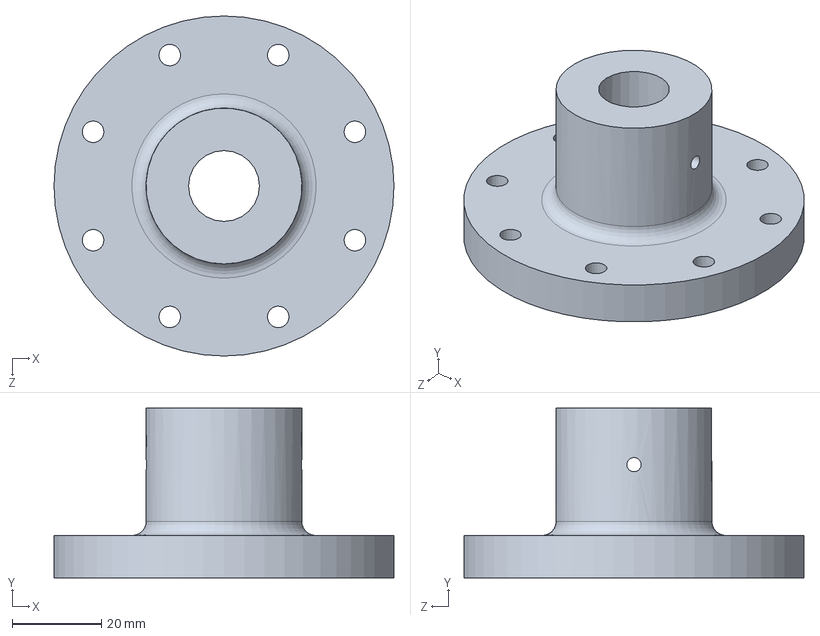
[picture p55: CAD file, 2016-12-03]
CAD/Spinner Hub.SLDPRT
76.2 x 38.1 x 76.2 mm
