carlosgj/Lorentz-Stirrer/CAD/8020 shaft.SLDPRT

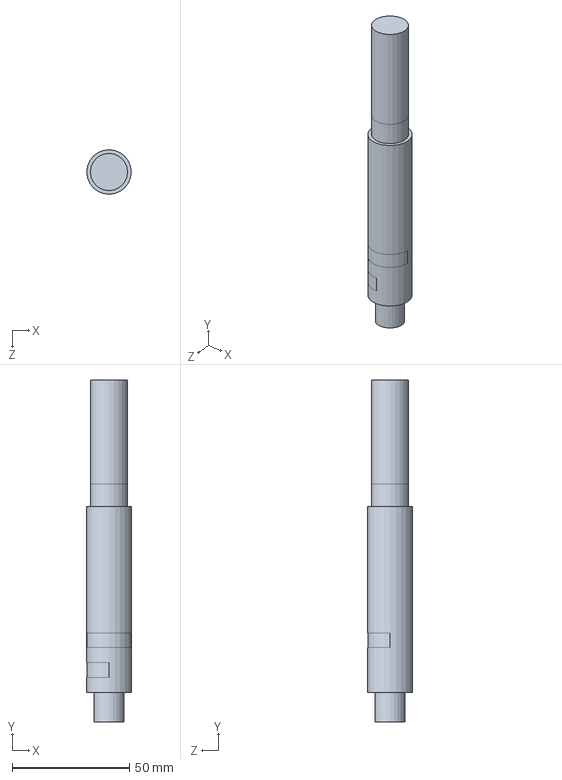
[picture p56: CAD file, 2016-12-03]
CAD/8020 shaft.SLDPRT
19.1 x 146.1 x 19.1 mm
