carlosgj/Lorentz-Stirrer/CAD/Gearbox/775 Pro.SLDPRT

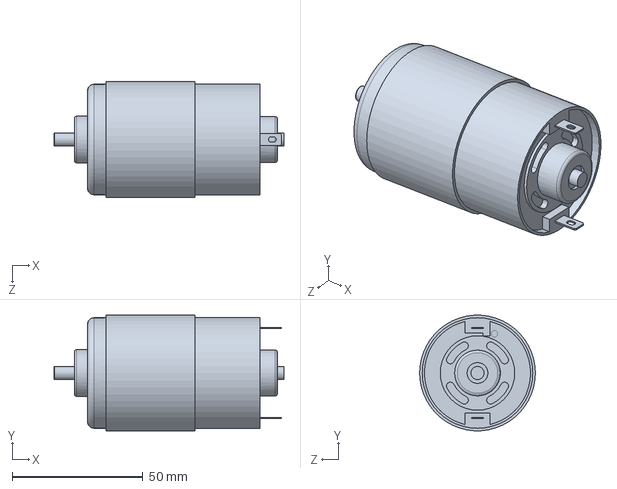
[picture p57: CAD file, 2017-06-16]
CAD/Gearbox/775 Pro.SLDPRT
88.0 x 44.2 x 44.3 mm
