carlosgj/Lorentz-Stirrer/CAD/8020 Bottom bearing holder.SLDPRT

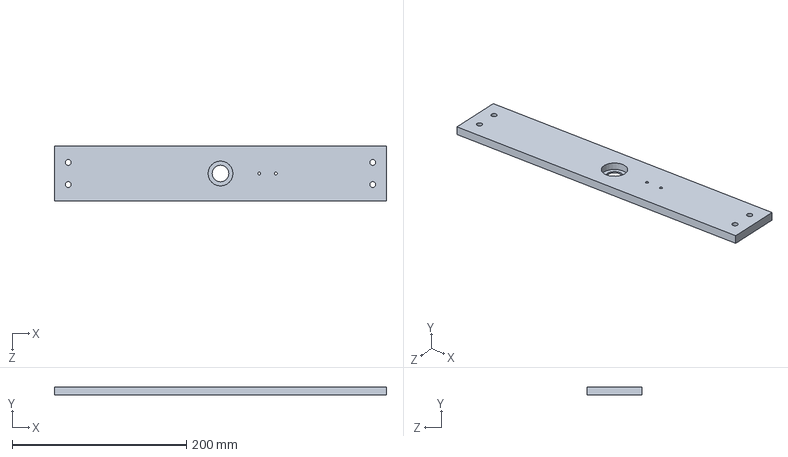
[picture p58: CAD file, 2016-12-03]
CAD/8020 Bottom bearing holder.SLDPRT
381.0 x 9.53 x 63.5 mm
