carlosgj/Lorentz-Stirrer/CAD/8020 motor holder.SLDPRT

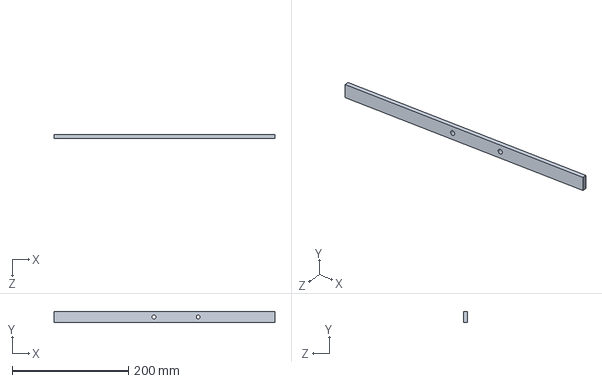
[picture p59: CAD file, 2016-12-03]
CAD/8020 motor holder.SLDPRT
381.0 x 19.1 x 6.35 mm
