carlosgj/Lorentz-Stirrer/CAD/Emergency bushing.SLDPRT

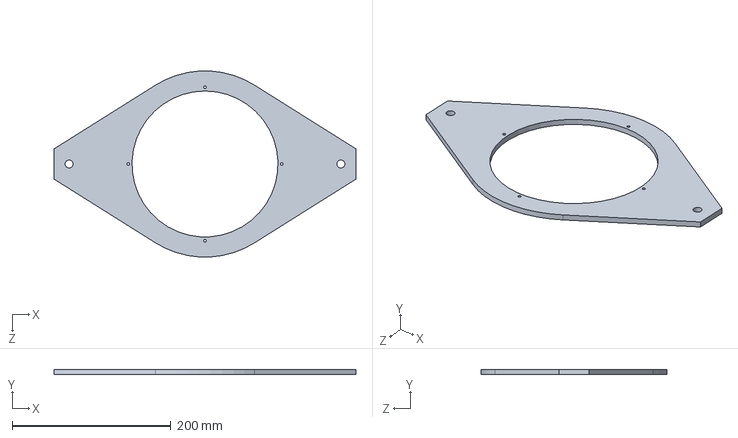
[picture p60: CAD file, 2016-10-27]
CAD/Emergency bushing.SLDPRT
381.0 x 6.35 x 234.5 mm
