carlosgj/Lorentz-Stirrer/CAD/OPB748.SLDPRT

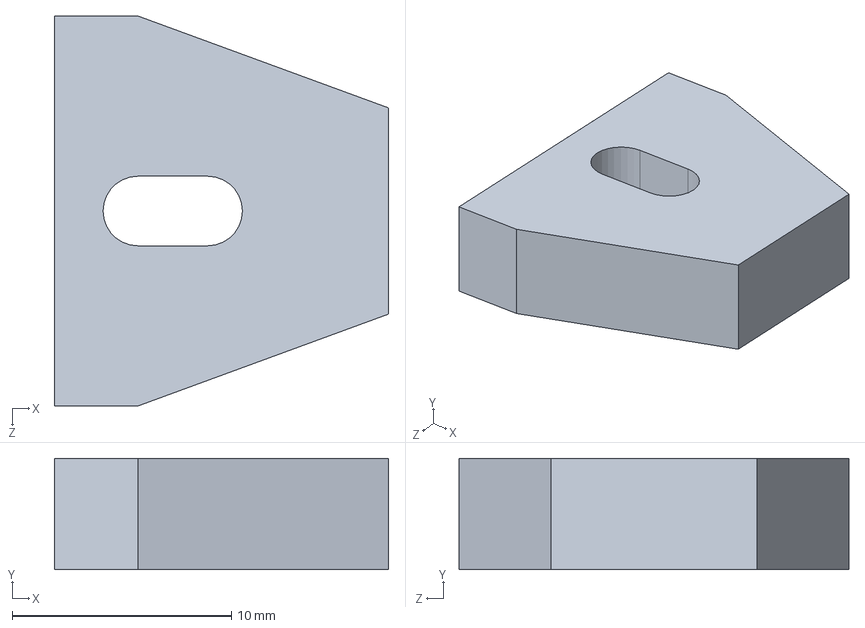
[picture p61: CAD file, 2016-10-26]
CAD/OPB748.SLDPRT
15.2 x 5.08 x 17.8 mm
