carlosgj/Lorentz-Stirrer/CAD/Encoder Holder.SLDPRT

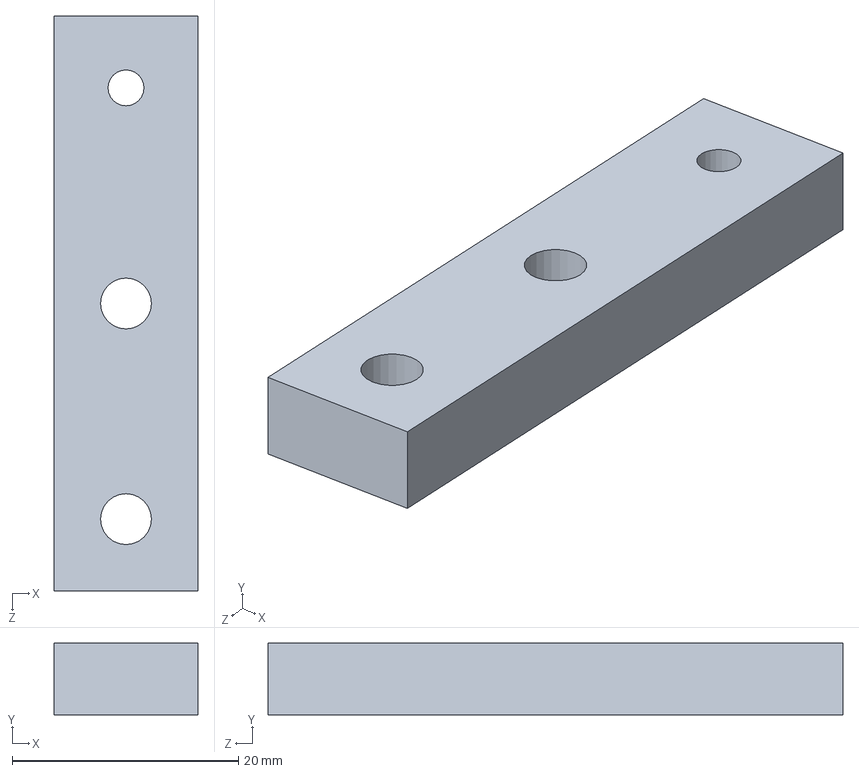
[picture p62: CAD file, 2016-10-26]
CAD/Encoder Holder.SLDPRT
12.7 x 6.35 x 50.8 mm
