carlosgj/Lorentz-Stirrer/CAD/Glass Support.SLDPRT

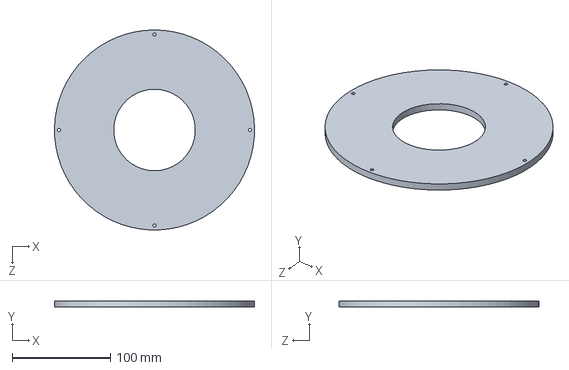
[picture p63: CAD file, 2016-10-26]
CAD/Glass Support.SLDPRT
203.1 x 6.35 x 203.2 mm
