carlosgj/Lorentz-Stirrer/CAD/Load Cell.SLDPRT

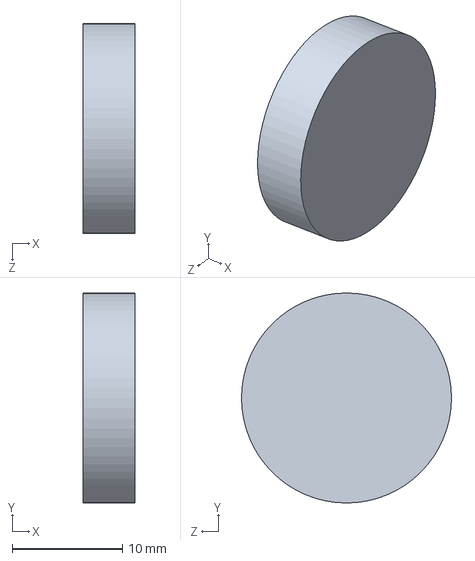
[picture p64: CAD file, 2016-10-26]
CAD/Load Cell.SLDPRT
4.76 x 19.1 x 19.1 mm
