carlosgj/Lorentz-Stirrer/CAD/End Shunt.SLDPRT

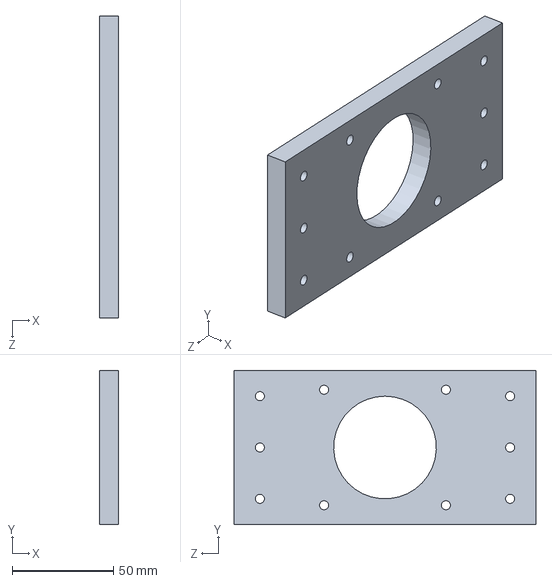
[picture p65: CAD file, 2016-10-20]
CAD/End Shunt.SLDPRT
9.53 x 76.2 x 149.2 mm
