carlosgj/Lorentz-Stirrer/CAD/Side Shunt.SLDPRT

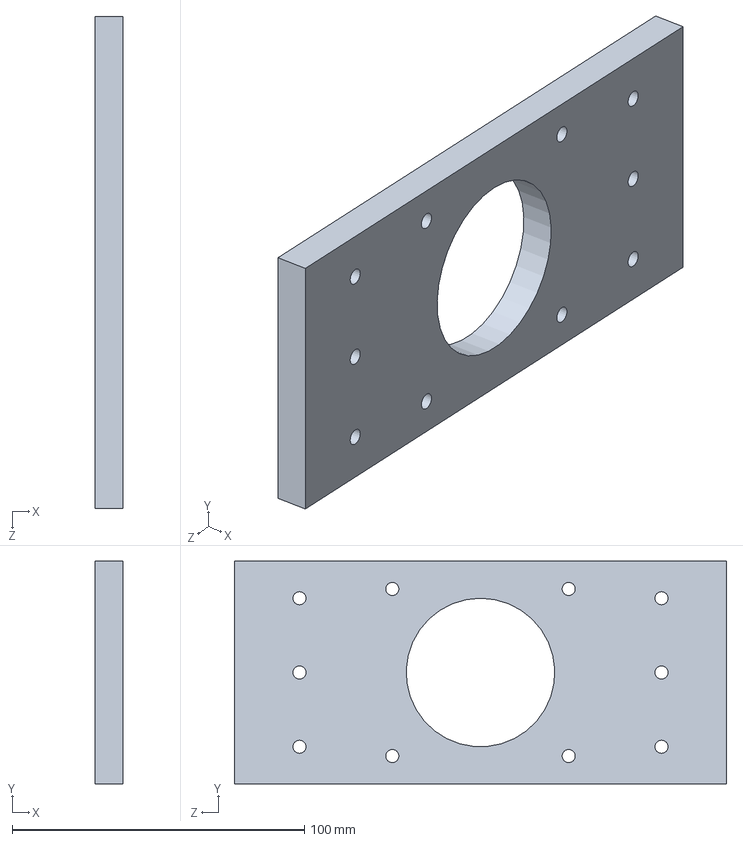
[picture p66: CAD file, 2016-10-20]
CAD/Side Shunt.SLDPRT
9.53 x 76.2 x 168.3 mm
