carlosgj/Lorentz-Stirrer/CAD/magnet holder.SLDPRT

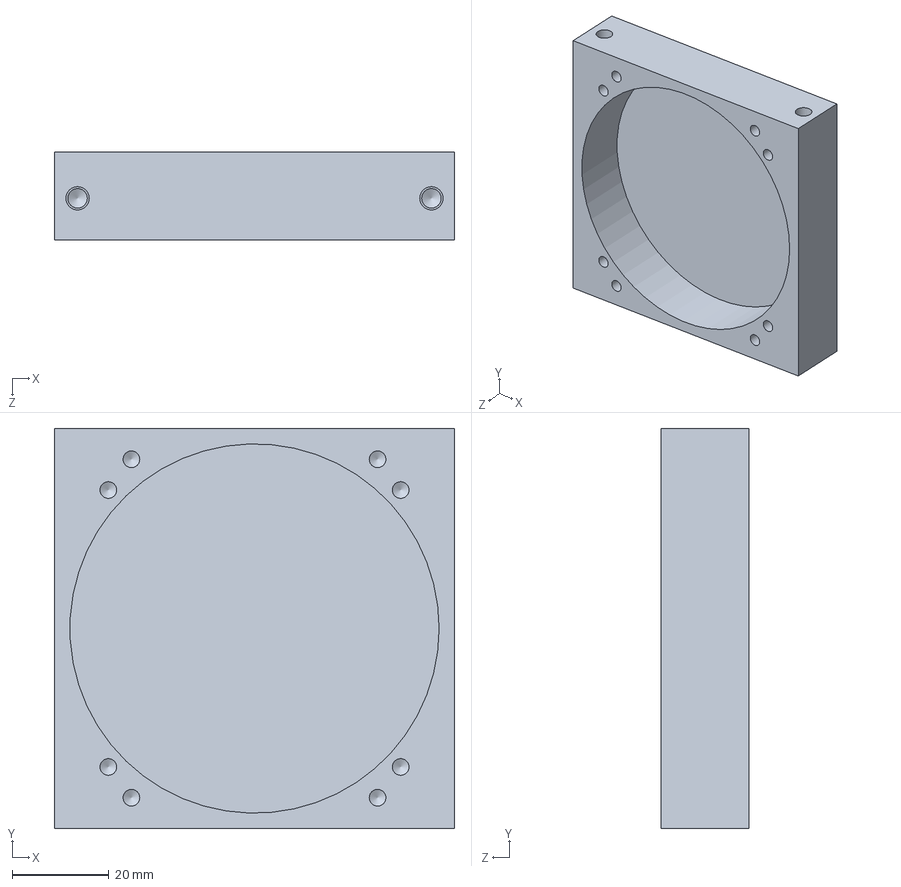
[picture p67: CAD file, 2016-10-20]
CAD/magnet holder.SLDPRT
82.5 x 82.5 x 18.1 mm
