carlosgj/Lorentz-Stirrer/CAD/Glass.SLDPRT

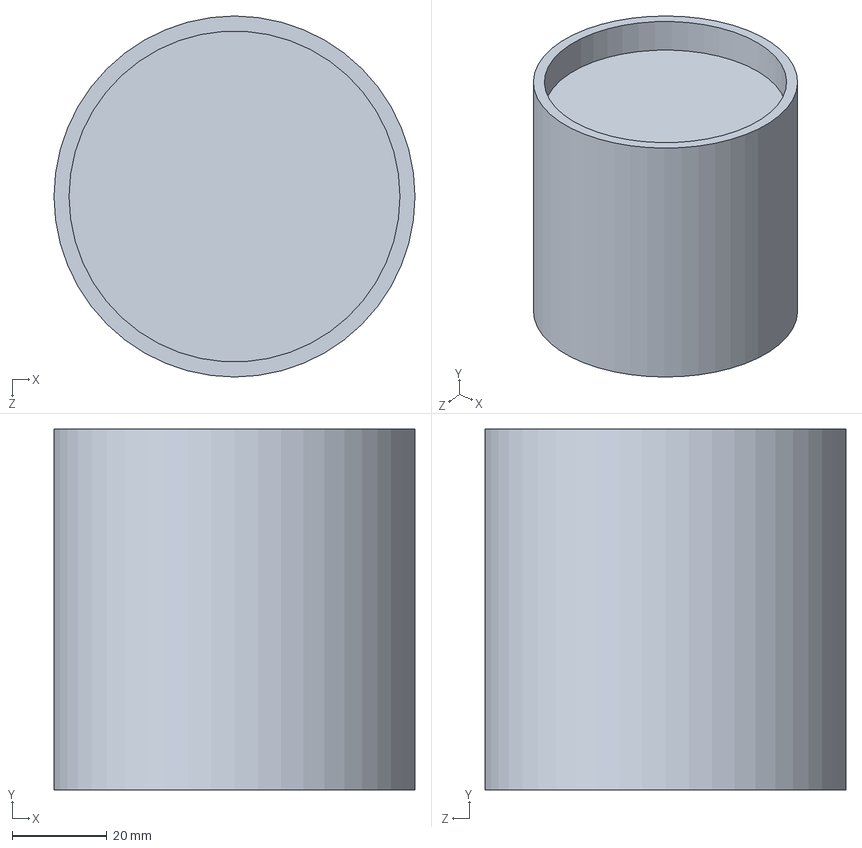
[picture p68: CAD file, 2016-10-20]
CAD/Glass.SLDPRT
76.2 x 76.2 x 76.2 mm
