carlosgj/Lorentz-Stirrer/CAD/8020 5 hole plate.SLDPRT

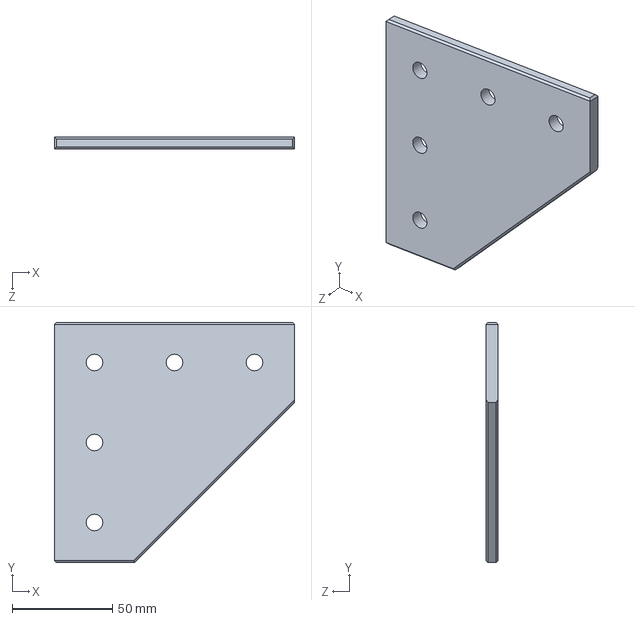
[picture p69: CAD file, 2016-10-20]
CAD/8020 5 hole plate.SLDPRT
120.0 x 120.0 x 6.00 mm
