carlosgj/Lorentz-Stirrer/CAD/8020 top bearing holder end.SLDPRT

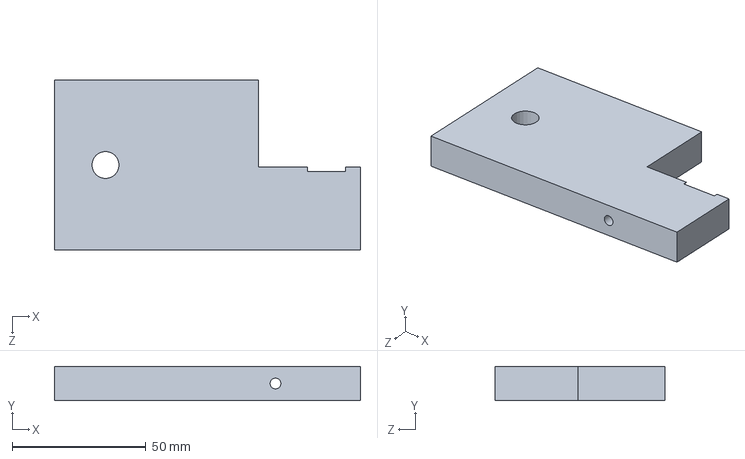
[picture p70: CAD file, 2016-10-20]
CAD/8020 top bearing holder end.SLDPRT
114.3 x 12.7 x 63.5 mm
