carlosgj/Lorentz-Stirrer/CAD/8020 8 inch.SLDPRT

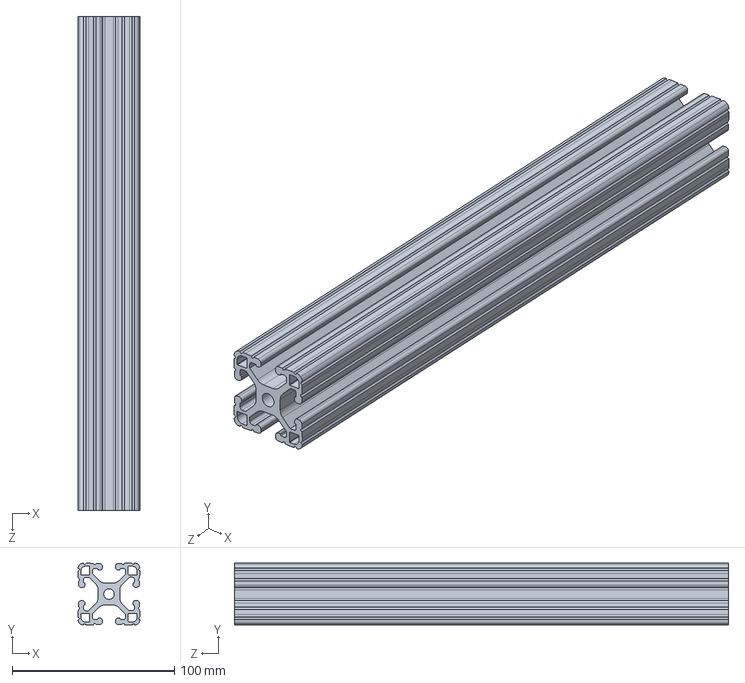
[picture p71: CAD file, 2016-10-20]
CAD/8020 8 inch.SLDPRT
38.1 x 38.2 x 304.8 mm
