carlosgj/Lorentz-Stirrer/CAD/Shunt Gusset.SLDPRT

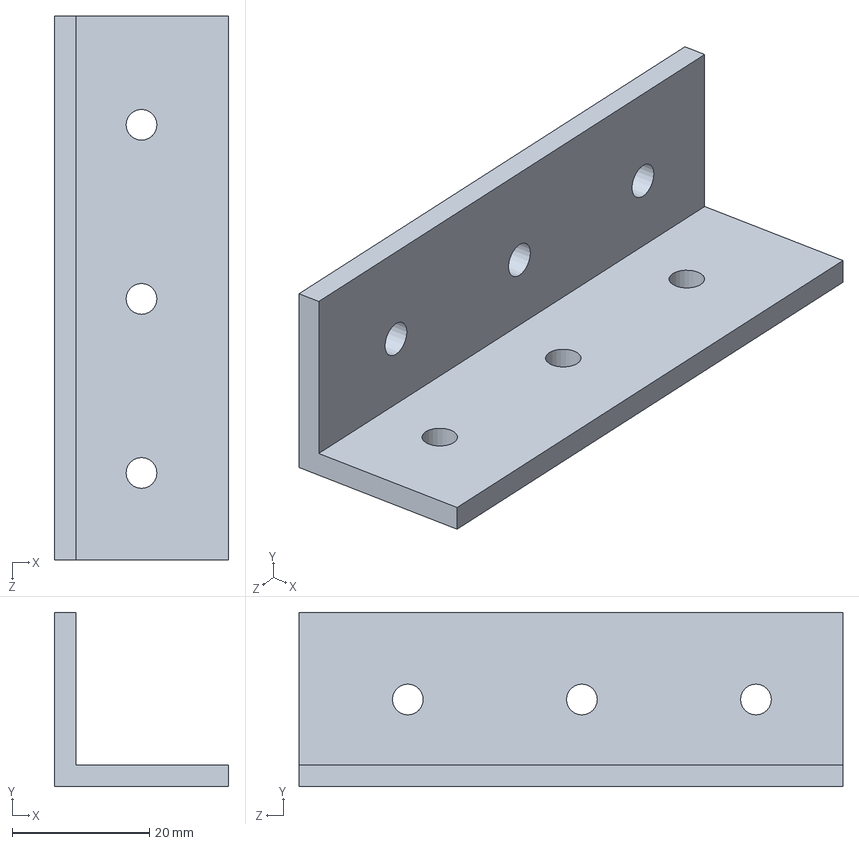
[picture p72: CAD file, 2016-10-18]
CAD/Shunt Gusset.SLDPRT
25.4 x 25.4 x 79.4 mm
