carlosgj/Lorentz-Stirrer/CAD/8020 coil holder.SLDPRT

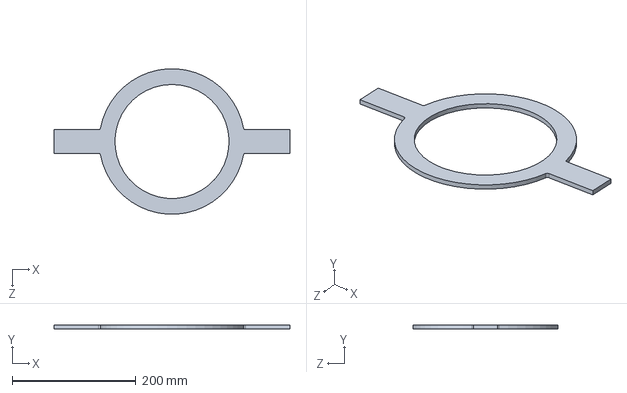
[picture p73: CAD file, 2016-10-18]
CAD/8020 coil holder.SLDPRT
381.0 x 6.35 x 234.4 mm
