carlosgj/Lorentz-Stirrer/CAD/magnet plate.SLDPRT

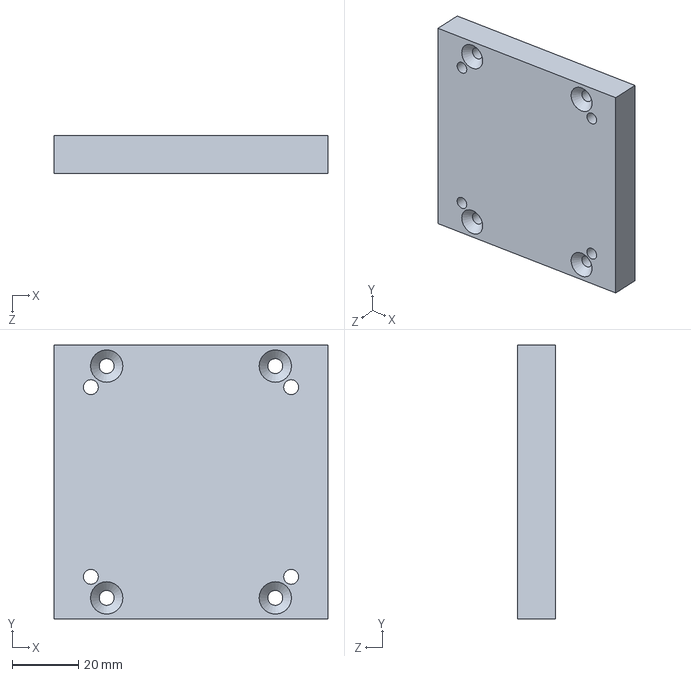
[picture p74: CAD file, 2016-10-17]
CAD/magnet plate.SLDPRT
82.5 x 82.5 x 11.4 mm
