carlosgj/Lorentz-Stirrer/CAD/top bearing.SLDPRT

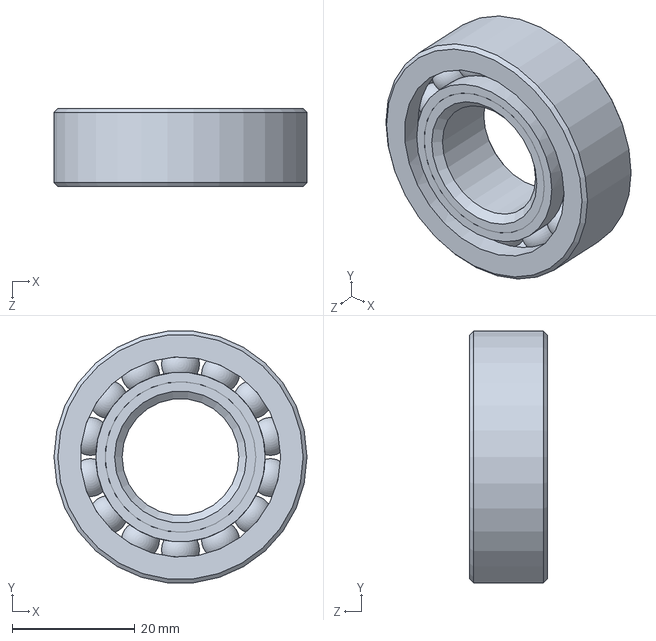
[picture p75: CAD file, 2016-10-17]
CAD/top bearing.SLDPRT
41.3 x 41.0 x 12.7 mm
