carlosgj/Lorentz-Stirrer/CAD/8020 4 inch.SLDPRT

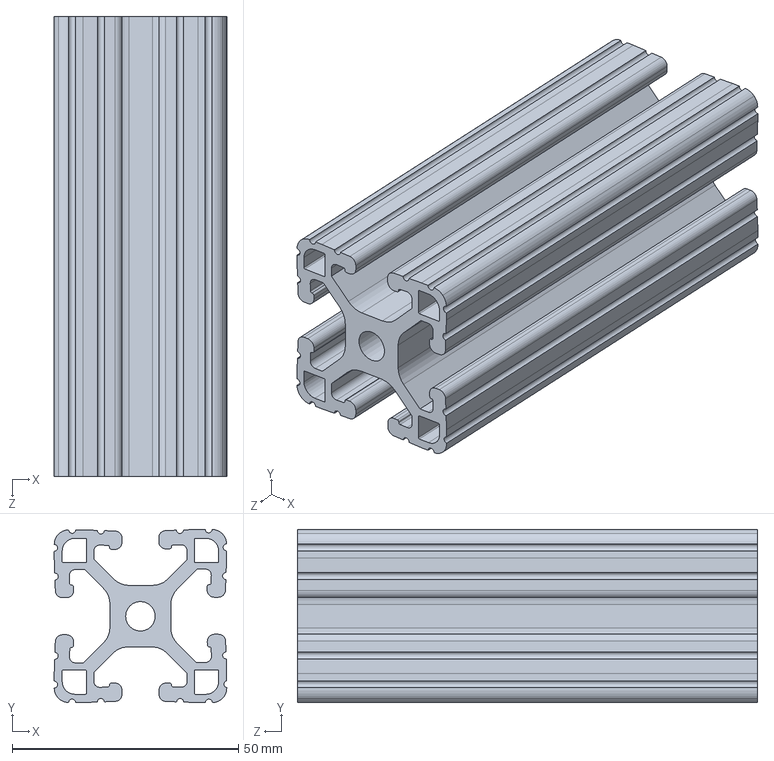
[picture p76: CAD file, 2016-10-17]
CAD/8020 4 inch.SLDPRT
38.1 x 38.2 x 101.6 mm
