carlosgj/Lorentz-Stirrer/CAD/8020 T plate.SLDPRT

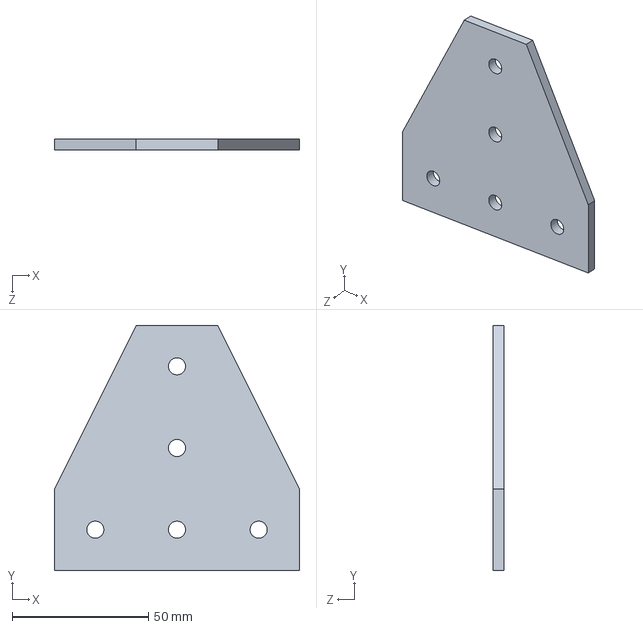
[picture p77: CAD file, 2016-10-17]
CAD/8020 T plate.SLDPRT
90.0 x 90.0 x 4.00 mm
