carlosgj/Lorentz-Stirrer/CAD/Magnet 31.SLDPRT

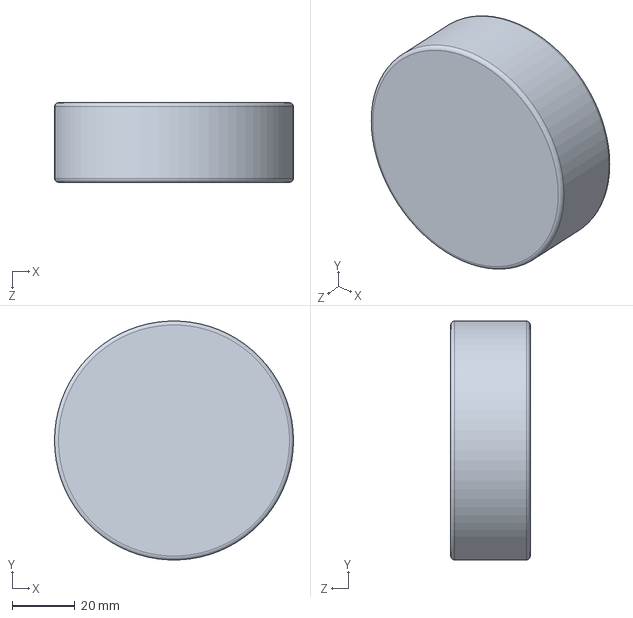
[picture p78: CAD file, 2016-10-17]
CAD/Magnet 31.SLDPRT
76.2 x 76.1 x 25.4 mm
