carlosgj/Lorentz-Stirrer/CAD/8020 thin t.SLDPRT

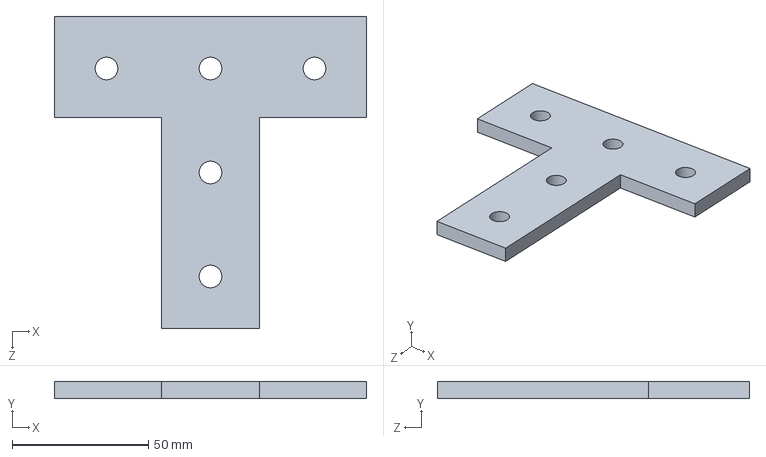
[picture p79: CAD file, 2016-10-17]
CAD/8020 thin t.SLDPRT
114.3 x 6.35 x 114.3 mm
