carlosgj/Lorentz-Stirrer/CAD/8020 T plate 2.SLDPRT

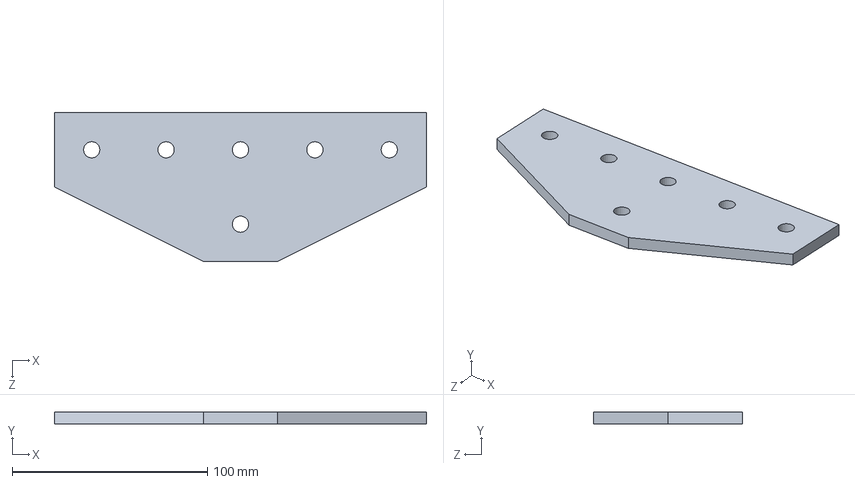
[picture p80: CAD file, 2016-10-17]
CAD/8020 T plate 2.SLDPRT
190.5 x 6.35 x 76.2 mm
