carlosgj/Lorentz-Stirrer/CAD/Bottom Bearing.SLDPRT

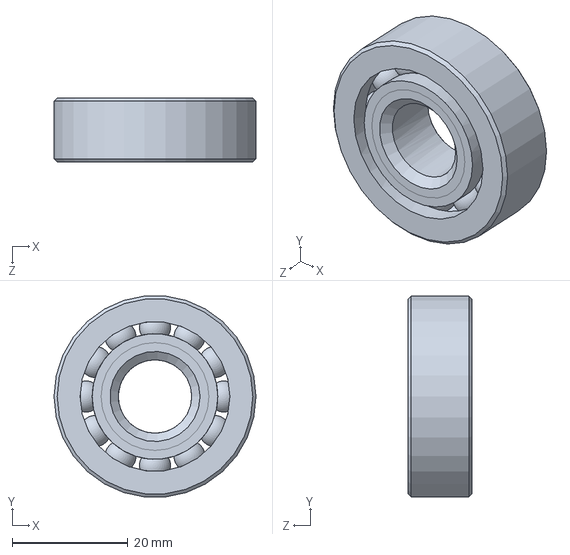
[picture p81: CAD file, 2016-10-17]
CAD/Bottom Bearing.SLDPRT
34.9 x 34.7 x 11.1 mm
