carlosgj/Lorentz-Stirrer/CAD/LN2 Cup.SLDPRT

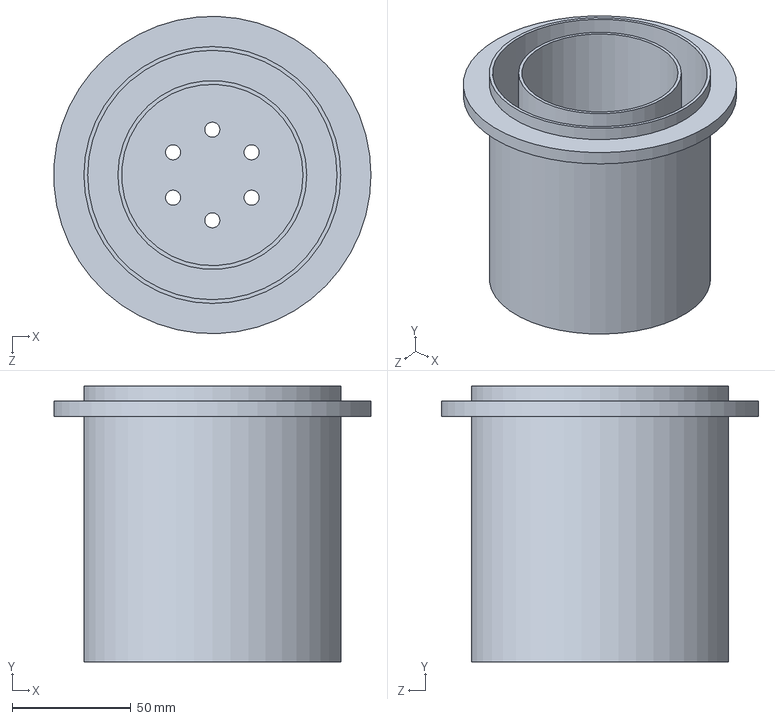
[picture p82: CAD file, 2016-09-11]
CAD/LN2 Cup.SLDPRT
133.2 x 115.9 x 133.3 mm
