carlosgj/Lorentz-Stirrer/CAD/coil.SLDPRT

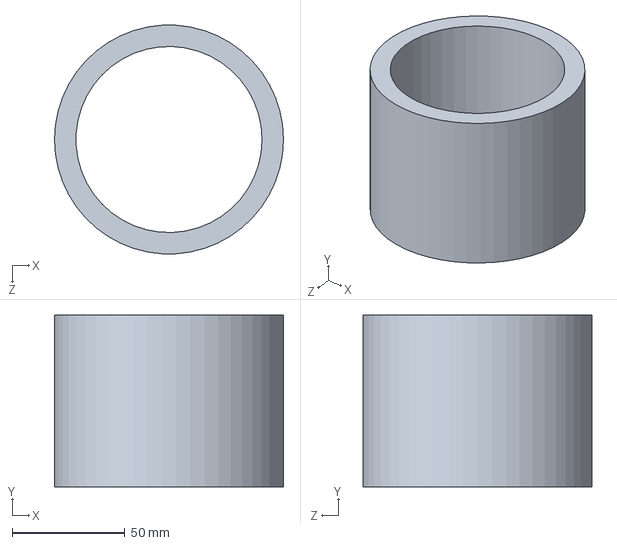
[picture p83: CAD file, 2016-09-11]
CAD/coil.SLDPRT
101.6 x 76.2 x 101.4 mm
