carlosgj/Lorentz-Stirrer/CAD/Bottom Bearing Holder.SLDPRT

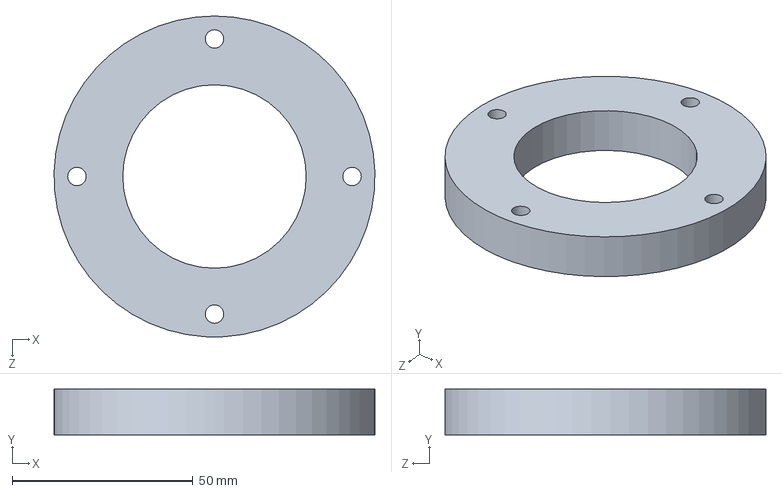
[picture p84: CAD file, 2016-08-16]
CAD/Bottom Bearing Holder.SLDPRT
88.9 x 12.7 x 88.9 mm
