carlosgj/Lorentz-Stirrer/CAD/driveshaft.SLDPRT

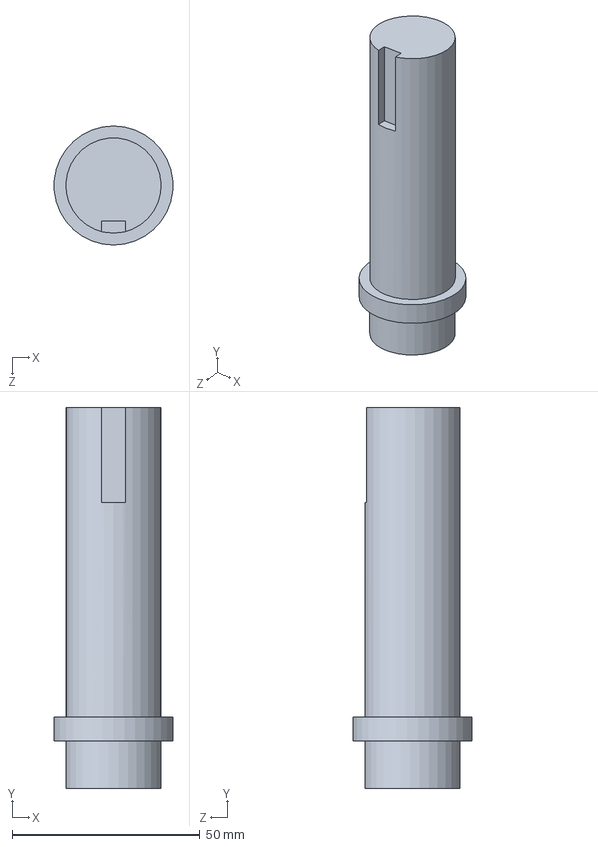
[picture p85: CAD file, 2016-08-16]
CAD/driveshaft.SLDPRT
31.6 x 101.6 x 31.8 mm
