carlosgj/Lorentz-Stirrer/CAD/Top Bearing Holder.SLDPRT

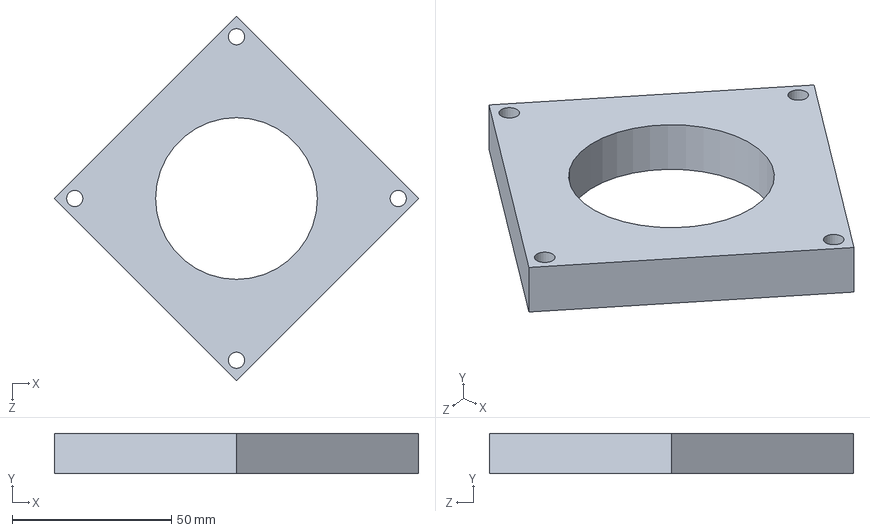
[picture p86: CAD file, 2016-08-16]
CAD/Top Bearing Holder.SLDPRT
114.3 x 12.7 x 114.3 mm
