carlosgj/Lorentz-Stirrer/CAD/Bottom Plate.SLDPRT

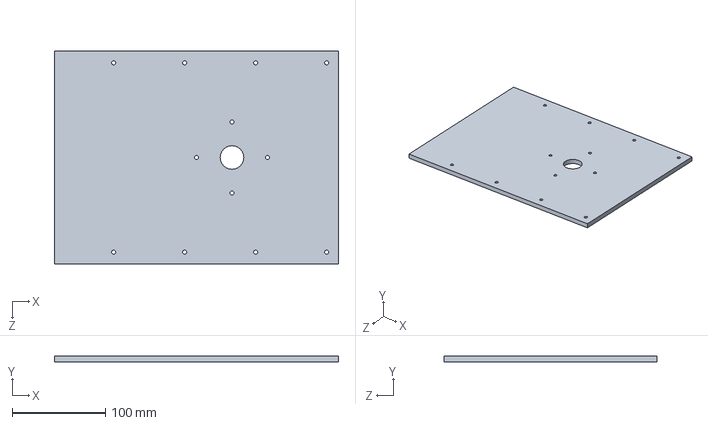
[picture p87: CAD file, 2016-08-16]
CAD/Bottom Plate.SLDPRT
304.8 x 6.35 x 228.6 mm
