carlosgj/Lorentz-Stirrer/CAD/bearing.SLDPRT

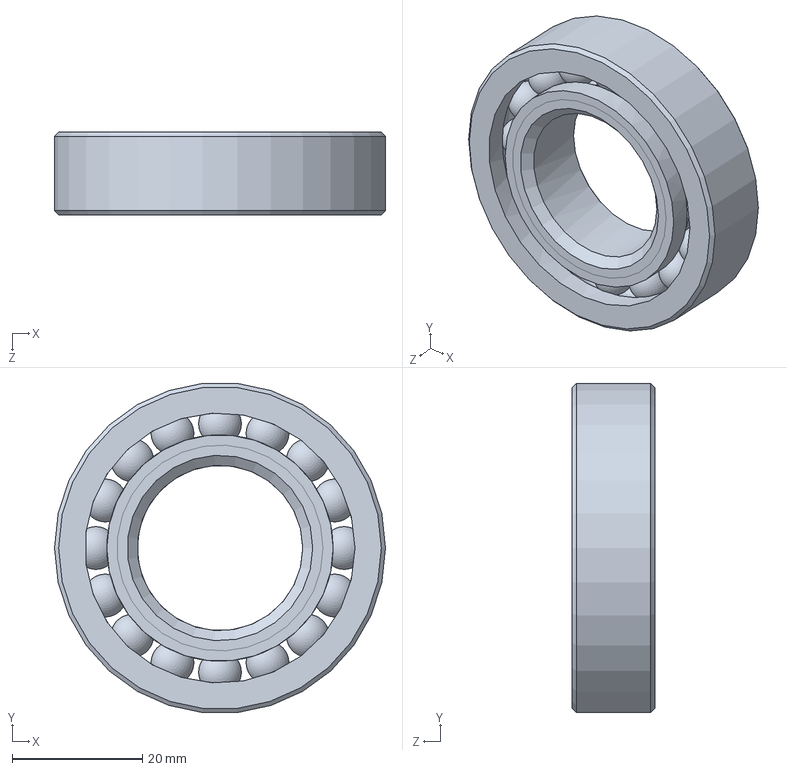
[picture p88: CAD file, 2016-08-16]
CAD/bearing.SLDPRT
50.8 x 50.5 x 12.7 mm
