carlosgj/Lorentz-Stirrer/CAD/Long spacer.SLDPRT

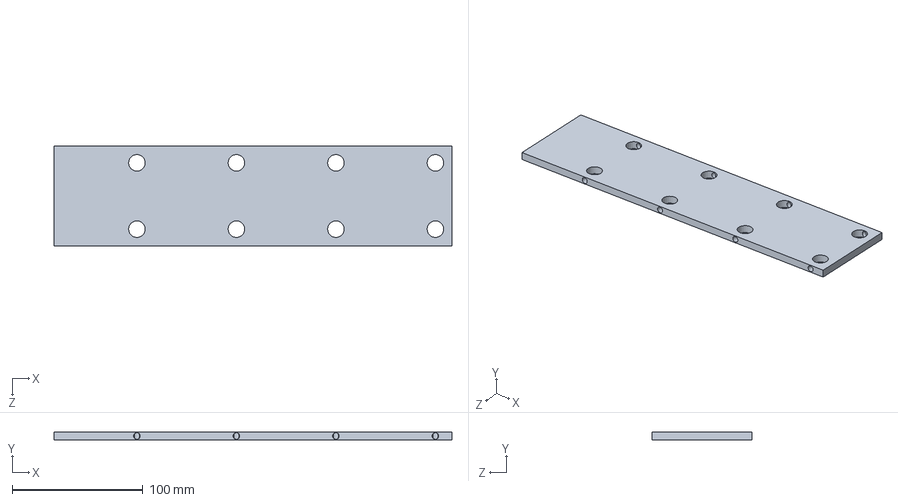
[picture p89: CAD file, 2016-08-16]
CAD/Long spacer.SLDPRT
304.8 x 6.35 x 76.2 mm
