carlosgj/Lorentz-Stirrer/CAD/User Library-2_5 CIM Motor.SLDPRT

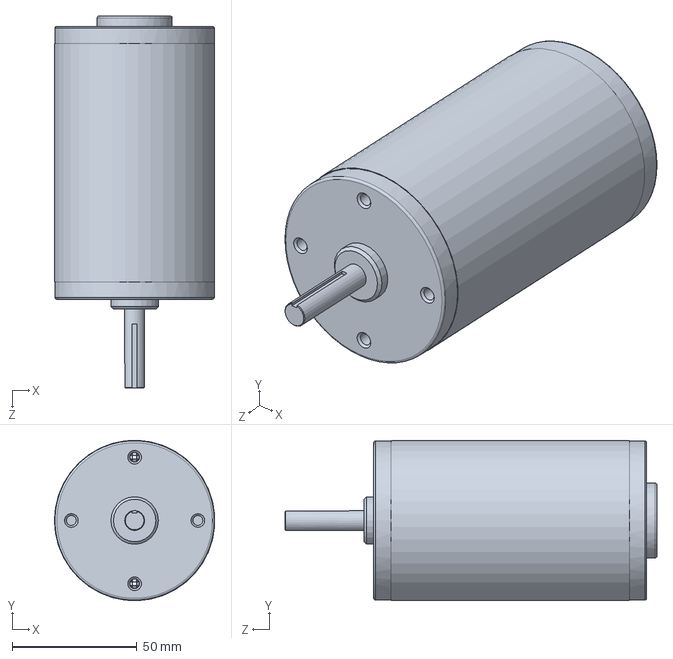
[picture p90: CAD file, 2016-08-16]
CAD/User Library-2_5 CIM Motor.SLDPRT
64.3 x 64.4 x 149.3 mm
