carlosgj/Lorentz-Stirrer/CAD/Top Plate.SLDPRT

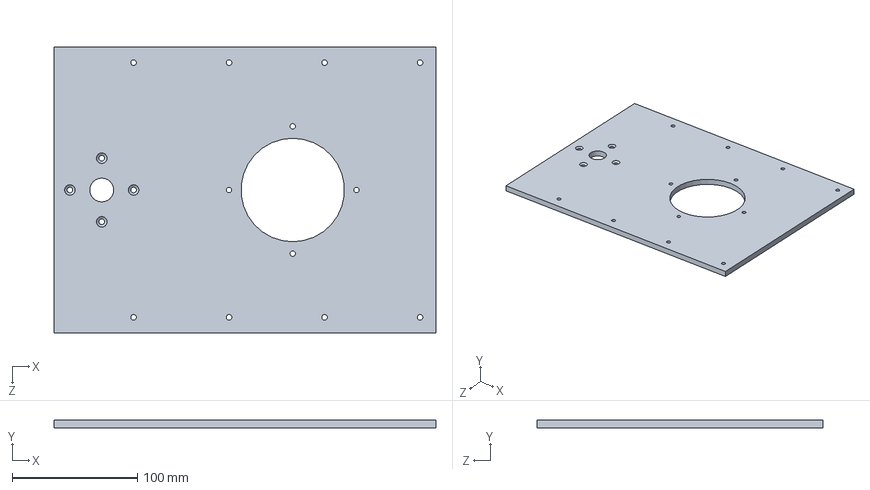
[picture p91: CAD file, 2016-08-16]
CAD/Top Plate.SLDPRT
304.8 x 6.35 x 228.6 mm
