carlosgj/Lorentz-Stirrer/CAD/top bearing ring.SLDPRT

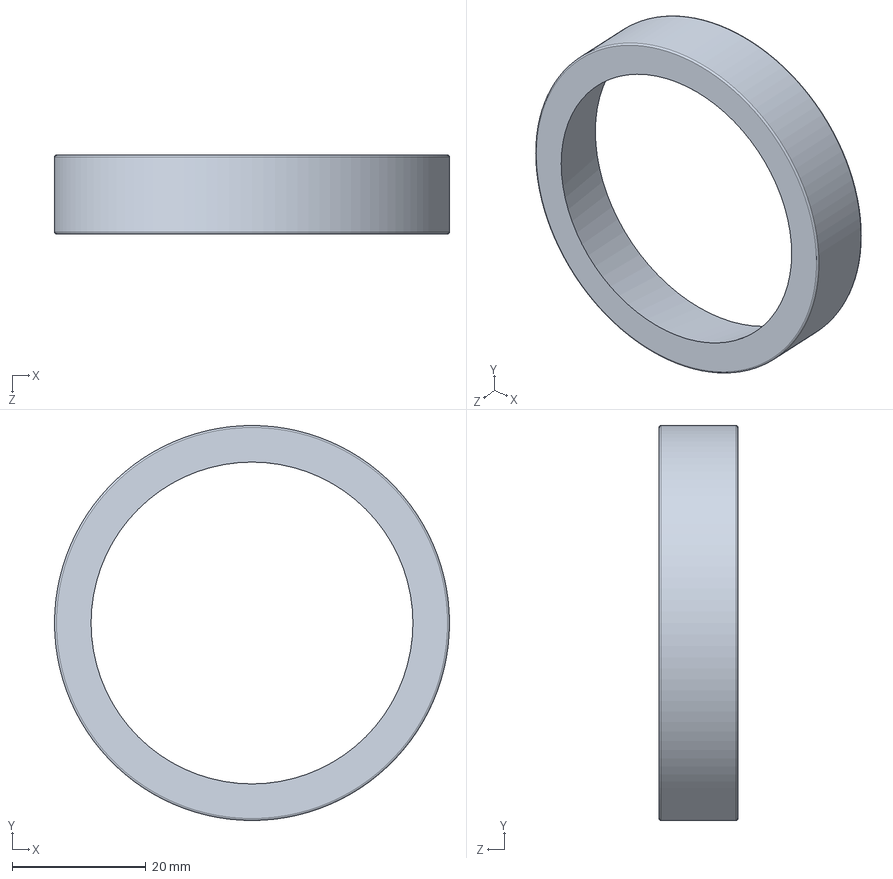
[picture p92: CAD file, 2016-08-16]
CAD/top bearing ring.SLDPRT
59.1 x 59.1 x 11.8 mm
