carlosgj/Lorentz-Stirrer/(list of files, cad)

Other CAD files:
CAD/Gearbox/217-2625-100.sldasm
CAD/CIM Motor/10-24 UNC x 4_ Phillips Pan Head.sldprt
CAD/Gearbox/217-2724-003 Rev1_Planet_Revolving_Follower01.sldprt
CAD/Gearbox/v2-VersaPlanetary-1stage-with-775pro-20161031/217-2625-010 Rev1.sldprt
CAD/Gearbox/217-2625-026 Rev1.sldprt
CAD/Gearbox/217-2625-013 Rev1.sldprt
CAD/Gearbox/SSA_SSA0832-0750ZC.sldprt
CAD/Gearbox/217-2625-007 Rev1_Public.sldprt
CAD/Gearbox/217-2724-002 Rev1.sldprt
CAD/Gearbox/217-3141-004 Rev1.sldprt
CAD/Gearbox/217-2625-005 Rev1_Planet_Revolving_Follower01.sldprt
CAD/Gearbox/217-2724-001 Rev1_Sun_Driver01.sldprt
CAD/Gearbox/217-2625-003 Rev1.sldprt
CAD/Gearbox/217-3141-001 Rev1.sldprt
CAD/Gearbox/217-2742-001 Rev4.sldprt
CAD/Gearbox/217-2741.sldprt
CAD/Gearbox/217-3141-006 Rev1_30T 32DP.sldprt
CAD/Gearbox/217-2625-018 Rev1_98541A410.sldprt
CAD/Gearbox/SSA_SSAM4-0010ZC.sldprt
CAD/Gearbox/217-2625-010 Rev1.sldprt
CAD/OPB708.SLDPRT
CAD/Gearbox/217-2816-001 Rev1.sldprt
CAD/Gearbox/217-3141-007 Rev1_30T 32DP.sldprt
CAD/Gearbox/PINL-M020-006-S.sldprt
CAD/Gearbox/217-2625-008 Rev1.sldprt
CAD/Gearbox/SSS1032-0188-ZB.sldprt
CAD/2737T135_FINISHED-BORE SPROCKET FOR ANSI ROLLER CHAIN.SLDPRT
CAD/60355K601_BALL BEARING.SLDPRT
CAD/60355K602_BALL BEARING.SLDPRT
CAD/6383K251_BALL BEARING.SLDPRT
CAD/8020_base.SLDPRT
CAD/CIM Motor/CIM Motor.igs
CAD/CIM Motor/CIM motor.sldprt
CAD/Gearbox/832-1750-Ring-Gear-Screw_SSA0832-0500ZC.sldprt
CAD/Gearbox/91251A346_91251A346.sldprt
CAD/Gearbox/NUT-832-NYLOCK.sldprt
