carlosgj/Lorentz-Stirrer/CAD/Magnet Assembly Exploded Render.png

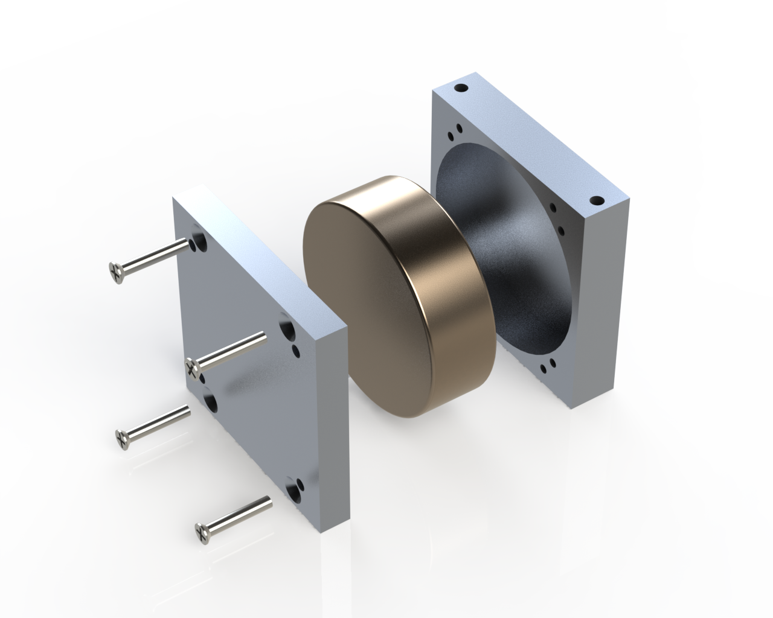
CAD/Magnet Assembly Exploded Render.png
