carlosgj/Lorentz-Stirrer/CAD/Pictures/Spinner assembly cutaway.PNG

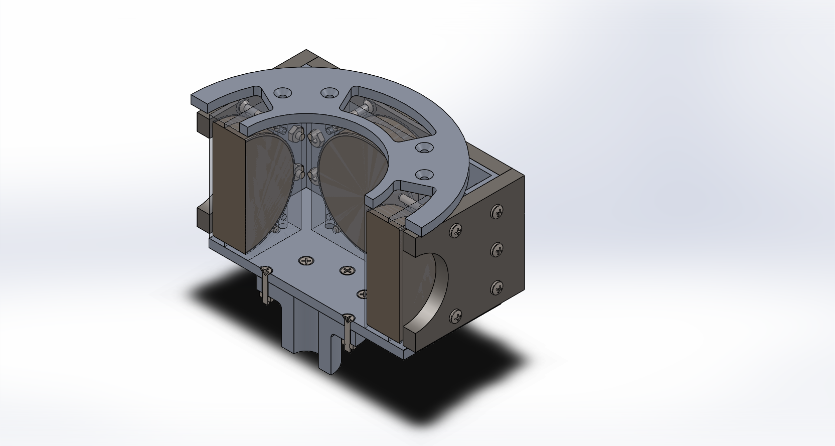
CAD/Pictures/Spinner assembly cutaway.PNG
