carlosgj/Lorentz-Stirrer/CAD/Spinner Assembly Exploded Render.png

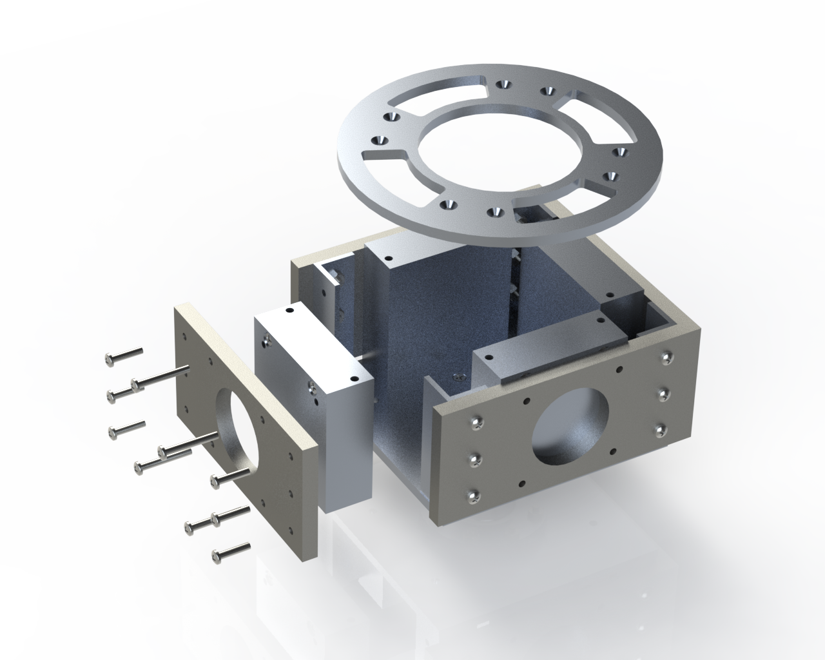
CAD/Spinner Assembly Exploded Render.png
