carlosgj/Lorentz-Stirrer/test.pdf

Project1 - Maxwell3DDesign1 - Modeler | Wednesda,ySeptember 21, 2016

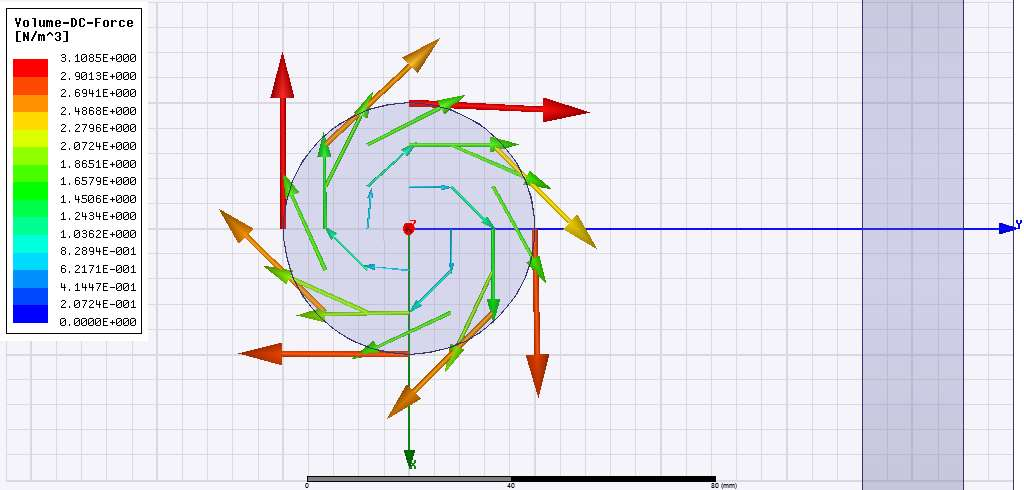
[picture p96: figure]
