carlosgj/Lorentz-Stirrer/(list of files, drawings)

Other design files:
Conductivity.ms13
