carlosgj/Lorentz-Stirrer/Conductivity probe.brd

## EAGLE design Conductivity probe.brd (2016-12-03)

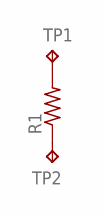
[picture p97: schematic Conductivity probe.sch]

Parts:
R1: R-US_0204/7; 0204/7
TP1, TP2: TPPAD1-17; P1-17

Connections:
unnamed: R1.2, TP1.TP
unnamed: R1.1, TP2.TP

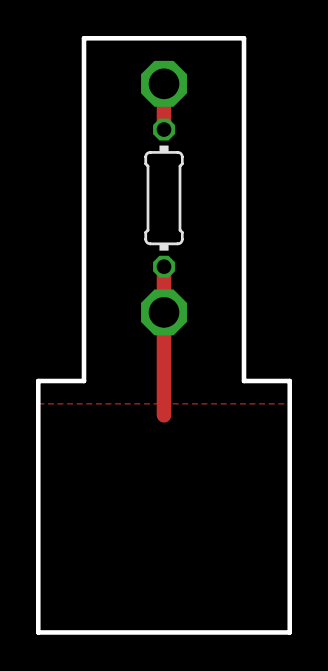
[picture p98: board Conductivity probe.brd from above]

Board: 2 copper layers, 14.0 x 33.0 mm, 3 parts (0 on the bottom side), 2 nets.
