carlosgj/Lorentz-Stirrer/(commit log)

2016-08-16 Version updates, apparently
    [12t sprocket.SLDPRT, 24t sprocket.SLDPRT, 8020 14 inch.SLDPRT, 8020 4 inch.SLDPRT, 8020 5 hole plate.SLDPRT, 8020 5 inch.SLDPRT, 8020 8 inch.SLDPRT, 8020 Bottom bearing holder.SLDPRT]
2016-09-11 CAD Updates
    [8020 14 inch.SLDPRT, 8020 4 inch.SLDPRT, 8020 5 hole plate.SLDPRT, 8020 5 inch.SLDPRT, 8020 8 inch.SLDPRT, 8020 Bottom bearing holder.SLDPRT, 8020 T plate 2.SLDPRT, 8020 T plate.SLDPRT]
2016-10-17 Upconvert & change to quadrature
    [12t sprocket.SLDPRT, 24t sprocket.SLDPRT, 8020 14 inch.SLDPRT, 8020 4 inch.SLDPRT, 8020 5 hole plate.SLDPRT, 8020 5 inch.SLDPRT, 8020 8 inch.SLDPRT, 8020 Bottom bearing holder.SLDPRT]
2016-10-18 Updated CAD
    [6383K251_BALL BEARING.SLDPRT, 8020 5 inch.SLDPRT, 8020 Bottom bearing holder.SLDPRT, 8020 coil holder.SLDPRT, 8020 shaft.SLDPRT, 8020 stand.SLDASM, 8020 top bearing holder.SLDPRT, 8020.SLDASM]
2016-10-20 Changed to load cell
    [8020 14 inch.SLDPRT, 8020 5 hole plate.SLDPRT, 8020 8 inch.SLDPRT, 8020 base.SLDASM, 8020 shaft.SLDPRT, 8020 stand.SLDASM, 8020 top bearing holder end.SLDPRT, 8020 top bearing holder.SLDPRT]
2016-10-26 Control system components
    [8020 Bottom bearing holder.SLDPRT, 8020 shaft.SLDPRT, Encoder Holder.SLDPRT, Front Mounting Plate.SLDPRT, Load Cell.SLDPRT, OPB708.SLDPRT, PS Bracket.SLDPRT, Power Supply.SLDPRT]
2016-10-26 Control system
    [8020 5 hole plate.igs, 8020 7 hole plate.SLDPRT, 8020 7 hole plate.igs, 8020 T plate 2.igs, 8020 T plate.igs, 8020 thin t.igs, BOM.xlsx, Encoder Holder.SLDPRT]
2016-10-27 Simplified shape
    [Emergency bushing.SLDPRT]
2016-11-07 Updates for machinability
    [Emergency bushing.SLDPRT, End Shunt.SLDPRT, Glass Support.SLDPRT, Magnet Assembly.SLDASM, Side Shunt.SLDPRT, Spinner assembly.SLDASM, bottom spinner plate.SLDPRT, magnet plate.SLDPRT]
2016-11-11 Instability analysis
    [Instability.xlsx]
2016-11-12 More old stuff
    [Seawater Analysis.xlsx]
2016-11-17 Added gearbox, changed to steel shaft
    [2737T122_FINISHED-BORE SPROCKET FOR ANSI ROLLER CHAIN.SLDPRT, 2737T124_FINISHED-BORE SPROCKET FOR ANSI ROLLER CHAIN.SLDPRT, 60355K601_BALL BEARING.SLDPRT, 60355K602_BALL BEARING.SLDPRT, 6280K353_FINISHED-BORE SPROCKET FOR ANSI ROLLER CHAIN.SLDPRT, 8020 Bottom bearing holder.SLDPRT, 8020 motor holder.SLDPRT, 8020 shaft.SLDPRT]
2017-01-05 Investigation of axial solenoid
2017-02-09 Added gearbox & rearranged electronics panel
    [12t sprocket.SLDPRT, 1_16 Inch Spacer.SLDPRT, 1_4 Inch Spacer.SLDPRT, 1_8 Inch Spacer.SLDPRT, 217-2592.SLDPRT, 217-2639.SLDPRT, 217-2702.SLDPRT, 217-2708.SLDPRT]
2017-02-23 Updates to gearbox
    [First Gear Shaft.SLDPRT, Gearbox.SLDASM, Middle Plate.SLDPRT, Motor Side Plate.SLDPRT, Output Side Plate.SLDPRT]
2017-03-15 Added aero cowling
    [8020 5 inch.SLDPRT, 8020 stand.SLDASM, Aero Cowling.SLDPRT, Front Mounting Plate.SLDPRT, Glass Holder.SLDPRT, Spinner assembly.SLDASM, bottom spinner plate.SLDPRT, top spinner plate.SLDPRT]
2017-06-16 Misc updates
    [1_16 Inch Spacer.SLDPRT, 1_4 Inch Spacer.SLDPRT, 1_8 Inch Spacer.SLDPRT, 217-2592.SLDPRT, 217-2625-003 Rev1.sldprt, 217-2625-005 Rev1_Planet_Revolving_Follower01.sldprt, 217-2625-007 Rev1_Public.sldprt, 217-2625-008 Rev1.sldprt]
